ahmad-ih/USB-Armory/README.md

View this project on [CADLAB.io](https://cadlab.io/project/22758). 

# USB-Armory
