ahmad-ih/USB-Armory/mark-one/armory.kicad_pcb

## KiCad design mark-one/armory.kicad_pcb (2020-04-04)

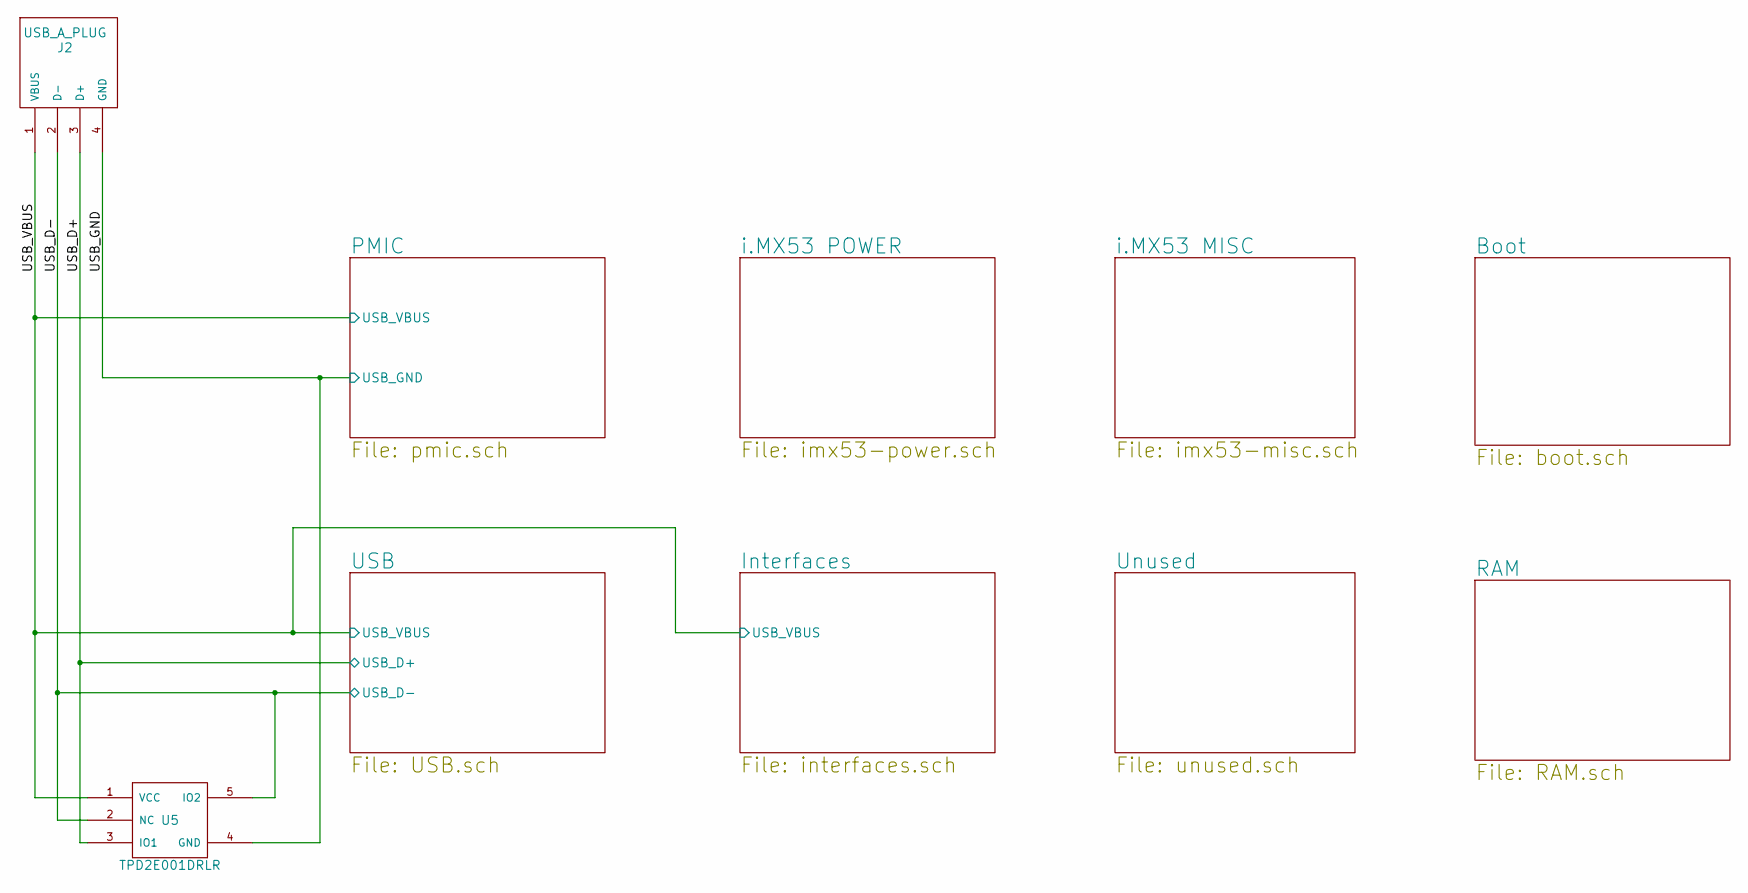
[picture p1: schematic armory.sch, USB ARMORY]

Parts:
J2: USB_A_PLUG; usb-PCB
U5: TPD2E001DRLR; R-PDSO-N5; Mfg PN TPD2E001DRLR

Connections:
/Interfaces/USB_VBUS: J2.1 (VBUS), U5.1 (VCC); also elsewhere on the board
/USB/USB_D+: J2.3 (D+), U5.3 (IO1); also elsewhere on the board
/USB/USB_D-: J2.2 (D-), U5.2 (NC), U5.5 (IO2); also elsewhere on the board
GND: J2.4 (GND), U5.4 (GND); also elsewhere on the board

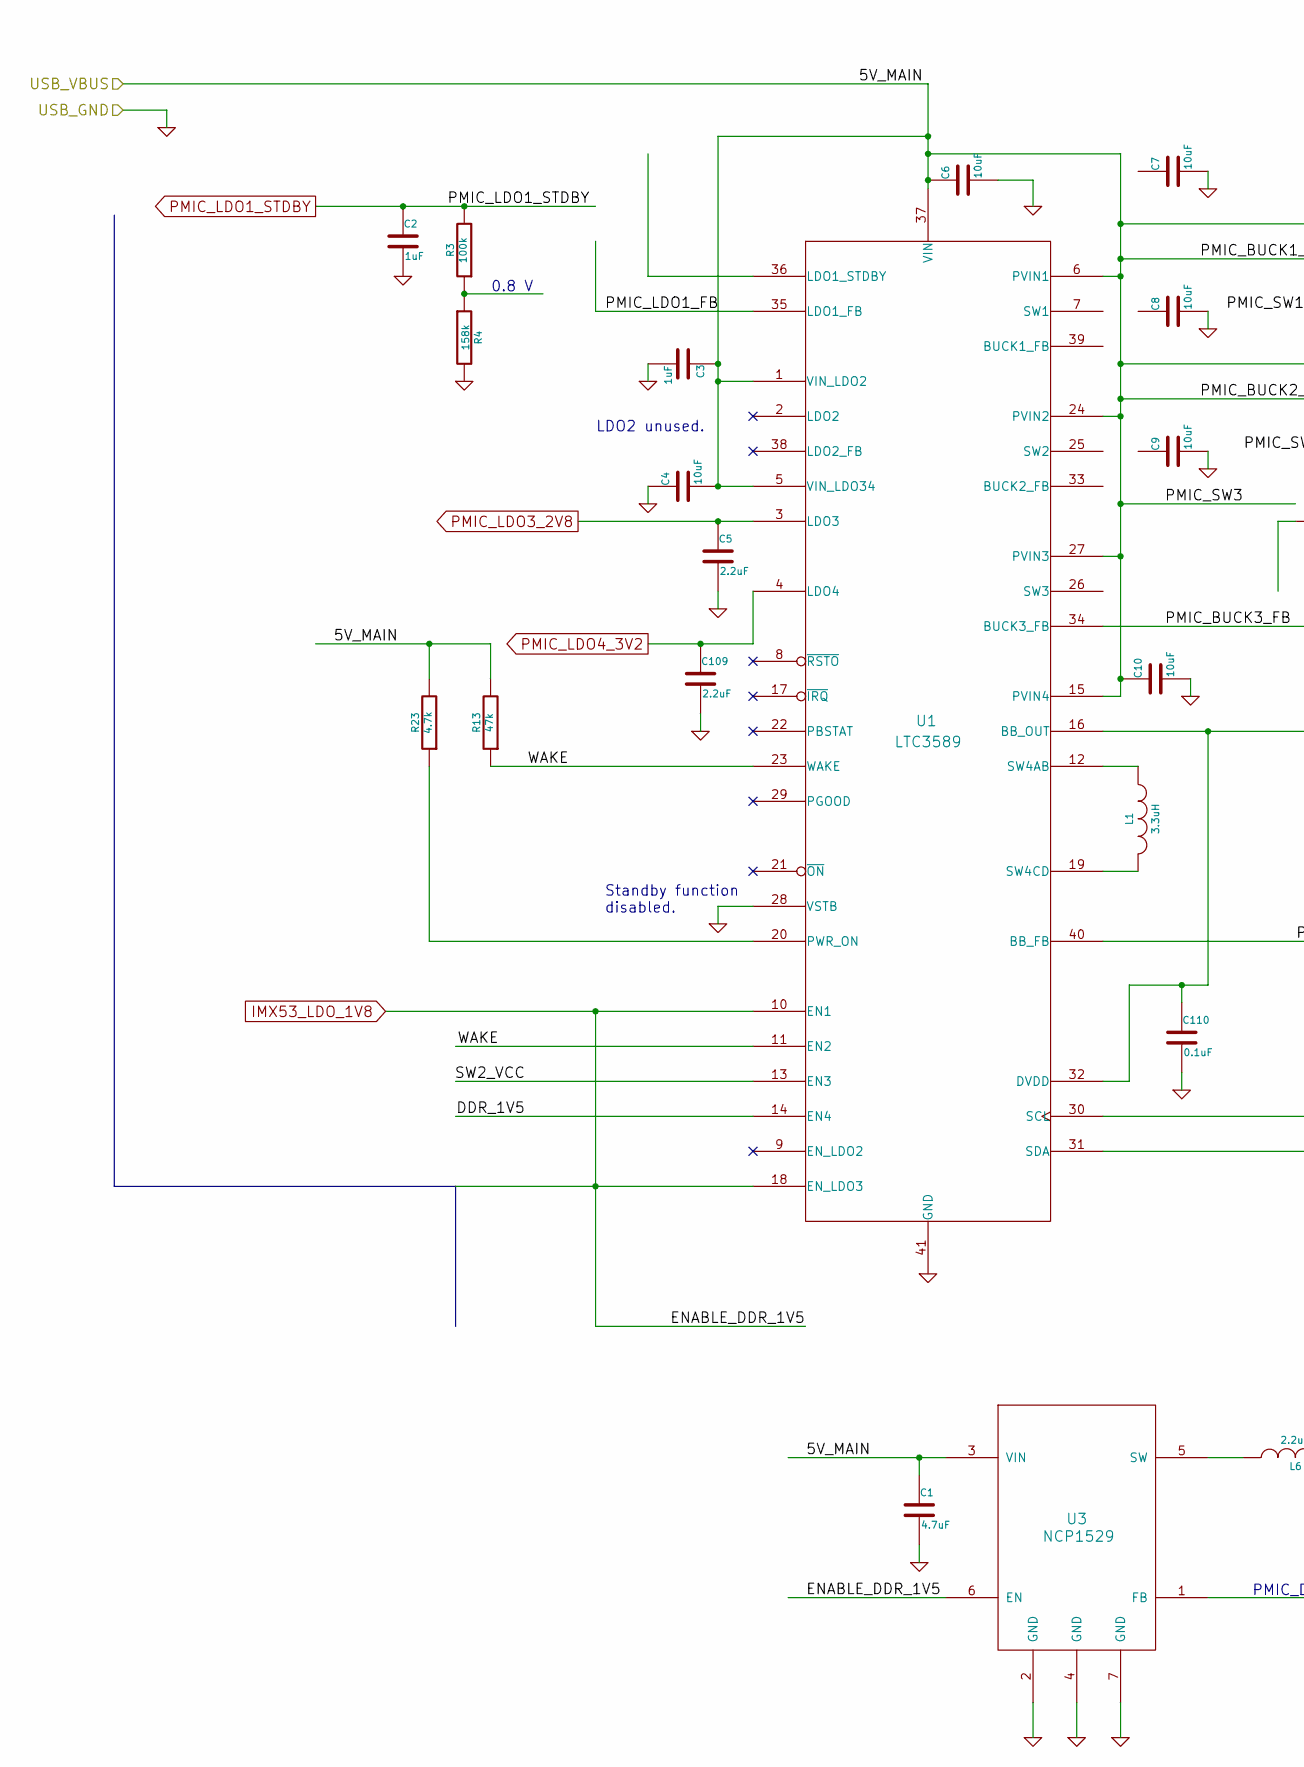
[picture p2: schematic pmic.sch, USB ARMORY - PMIC, part in row 1, column 1]

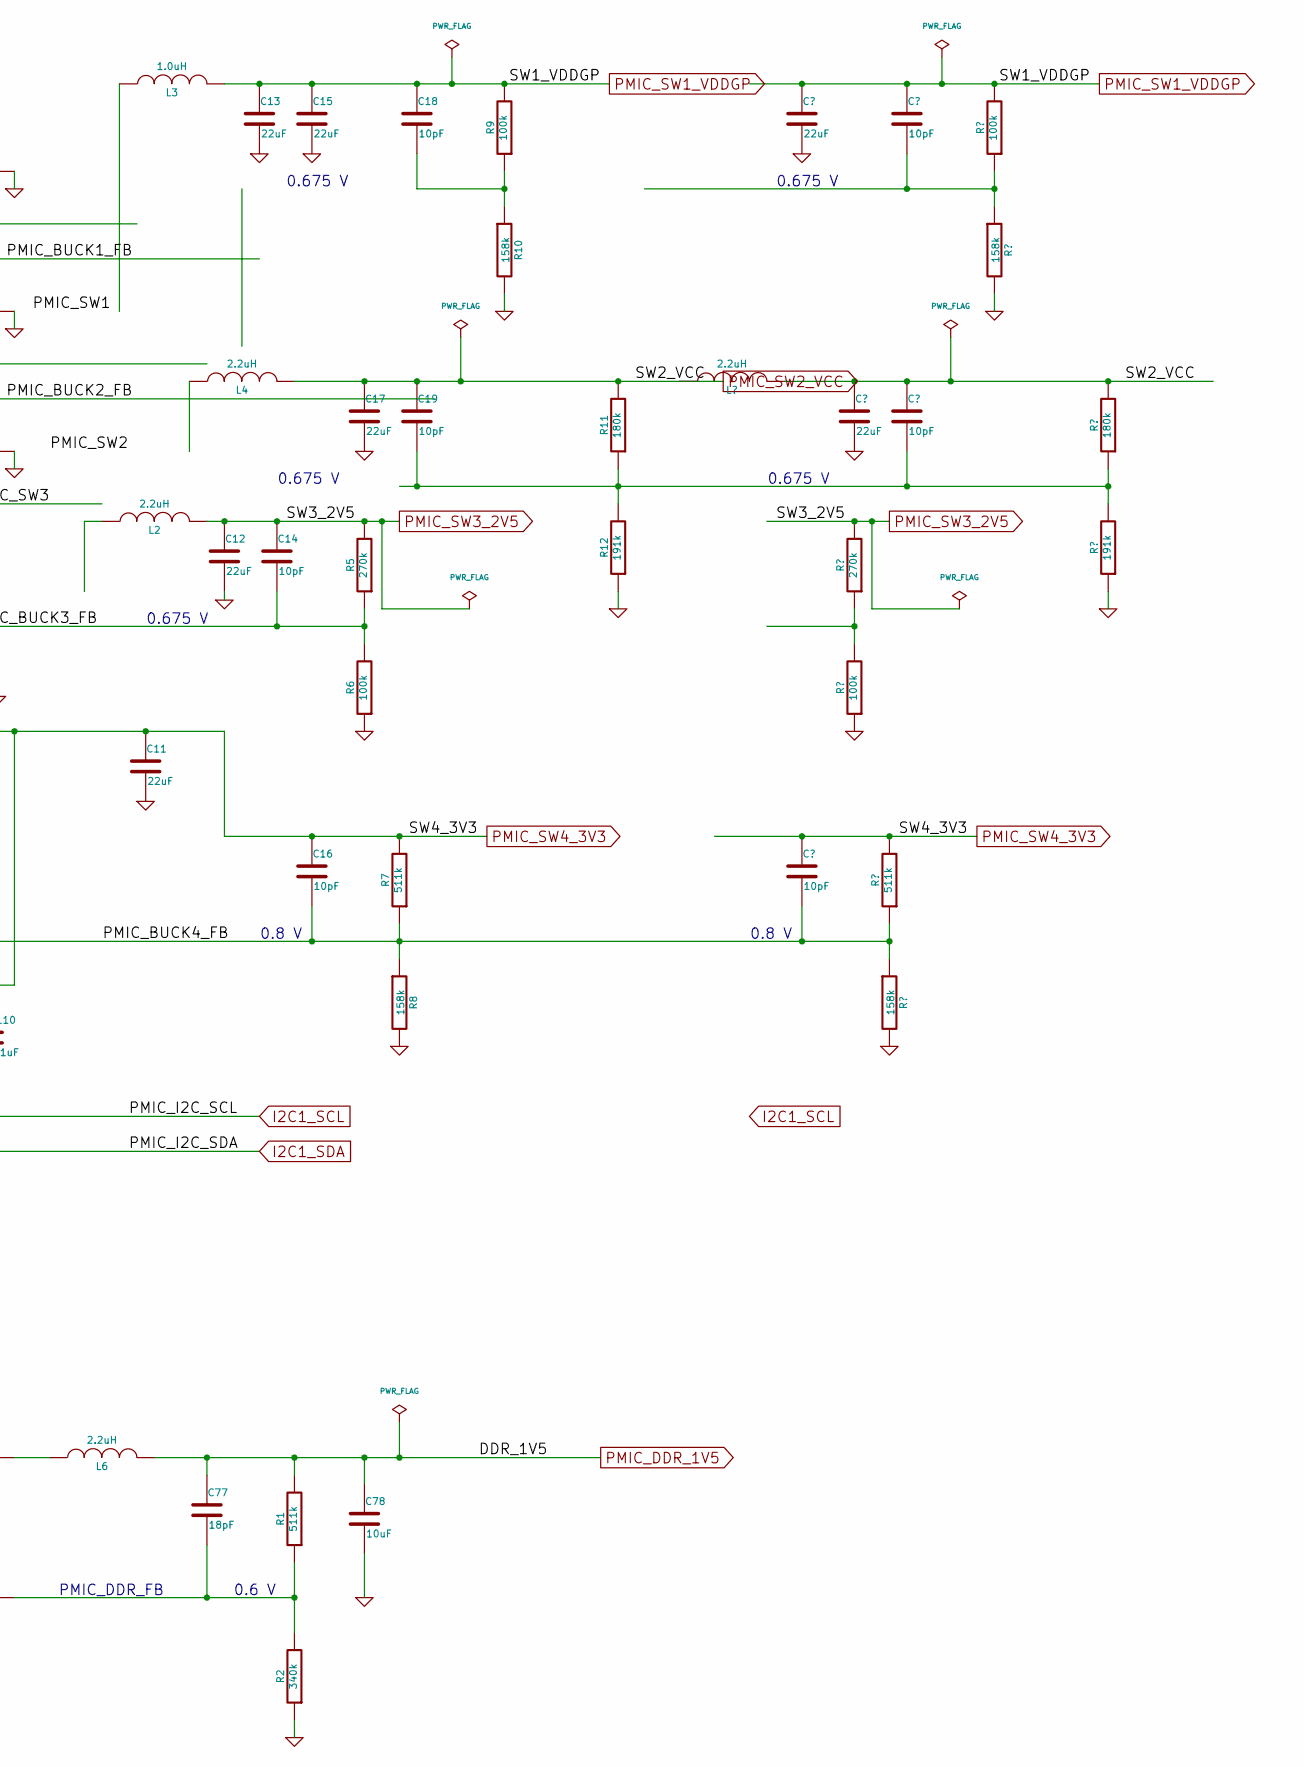
[picture p3: schematic pmic.sch, USB ARMORY - PMIC, part in row 1, column 2]

Parts:
C1: 4.7uF; SM0603; Mfg PN CGB3B1X5R1A475K055AC
C2, C3: 1uF; SM0201; Mfg PN C0603X5R0J105M030BC
C4, C6, C7, C8, C9, C10, C78: 10uF; SM0603; Mfg PN C1608X5R1A106K080AC
C5, C109: 2.2uF; SM0402; Mfg PN C1005X5R0J225K050BC
C11, C12, C13, C15, C17: 22uF; SM0603; Mfg PN C1608X5R0J226M080AC
C14, C16, C18, C19: 10pF; SM0402; Mfg PN 04025U100JAT2A
C77: 18pF; SM0201; Mfg PN C0603C0G1H180J030BA
C110: 0.1uF; SM0201; Mfg PN C0603X5R0J104K030BC
L1: 3.3uH; VLS252012ET; Mfg PN VLS252012ET-3R3M
L2, L4, L6: 2.2uH; VLS252012ET; Mfg PN VLS252012ET-2R2M
L3: 1.0uH; VLS252012ET; Mfg PN VLS252012ET-1R0N
R1, R7: 511k; SM0201; Mfg PN CRCW0201511KFNED
R2: 340k; SM0201; Mfg PN CRCW0201340KFNED
R3, R6, R9: 100k; SM0201; Mfg PN CRCW0201100KFNED
R4, R8, R10: 158k; SM0201; Mfg PN CRCW0201158KFNED
R5: 270k; SM0201; Mfg PN CRCW0201270KFNED
R11: 180k; SM0201; Mfg PN CRCW0201180KFNED
R12: 191k; SM0201; Mfg PN CRCW0201191KFNED
R13: 47k; SM0201; Mfg PN CRCW020147K0FNED
R23: 4.7k; SM0201; Mfg PN CRCW02014K70FNED
U1: LTC3589; ltc3589-QFN40; Mfg PN LTC3589EUJ-2#PBF
U3: NCP1529; Mfg PN NCP1529MUTBG

Connections:
/Interfaces/USB_VBUS: C1.1, C3.1, C4.2, C6.1, C7.1, C8.1, C9.1, C10.1, R13.2, R23.2, U1.1 (VIN_LDO2), U1.5 (VIN_LDO34), U1.6 (PVIN1), U1.15 (PVIN4), U1.24 (PVIN2), U1.27 (PVIN3), U1.37 (VIN), U3.3 (VIN); also elsewhere on the board
/PMIC/PMIC_BUCK1_FB: C18.2, R9.1, R10.1
/PMIC/PMIC_BUCK2_FB: C19.2, R11.1, R12.2
/PMIC/PMIC_BUCK3_FB: C14.2, R5.1, R6.2, U1.34 (BUCK3_FB)
/PMIC/PMIC_BUCK4_FB: C16.2, R7.1, R8.1, U1.40 (BB_FB)
/PMIC/PMIC_LDO1_FB: R3.1, R4.1
/PMIC/PMIC_SW1: L3.1
/PMIC/PMIC_SW3: L2.1
GND: C1.2, C2.2, C3.2, C4.1, C5.2, C6.2, C7.2, C8.2, C9.2, C10.2, C11.2, C12.2, C13.2, C15.2, C17.2, C78.2, C109.2, C110.2, R2.1, R4.2, R6.1, R8.2, R10.2, R12.1, U1.28 (VSTB), U1.41 (GND), U3.2 (GND), U3.4 (GND), U3.7 (GND); also elsewhere on the board
IMX53_LDO_1V8: U1.10 (EN1), U1.18 (EN_LDO3), U3.6 (EN); also elsewhere on the board
unnamed: C77.2, R1.1, R2.2, U3.1 (FB)
unnamed: L1.1, U1.12 (SW4AB)
unnamed: L1.2, U1.19 (SW4CD)
unnamed: L6.1, U3.5 (SW)
unnamed: R13.1, U1.11 (EN2), U1.23 (WAKE)
unnamed: R23.1, U1.20 (PWR_ON)
PMIC_DDR_1V5: C77.1, C78.1, L6.2, R1.2, U1.14 (EN4); also elsewhere on the board
PMIC_LDO1_STDBY: C2.1, R3.2; also elsewhere on the board
PMIC_LDO3_2V8: C5.1, U1.3 (LDO3); also elsewhere on the board
PMIC_LDO4_3V2: C109.1, U1.4 (LDO4); also elsewhere on the board
PMIC_SW1_VDDGP: C13.1, C15.1, C18.1, L3.2, R9.2; also elsewhere on the board
PMIC_SW2_VCC: C17.1, C19.1, L4.2, R11.2, U1.13 (EN3); also elsewhere on the board
PMIC_SW3_2V5: C12.1, C14.1, L2.2, R5.2; also elsewhere on the board
PMIC_SW4_3V3: C11.1, C16.1, C110.1, R7.2, U1.16 (BB_OUT), U1.32 (DVDD); also elsewhere on the board

Notes on the sheet:
Standby function disabled.
0.8 V
0.675 V
LDO2 unused.
0.6 V
PMIC_DDR_FB

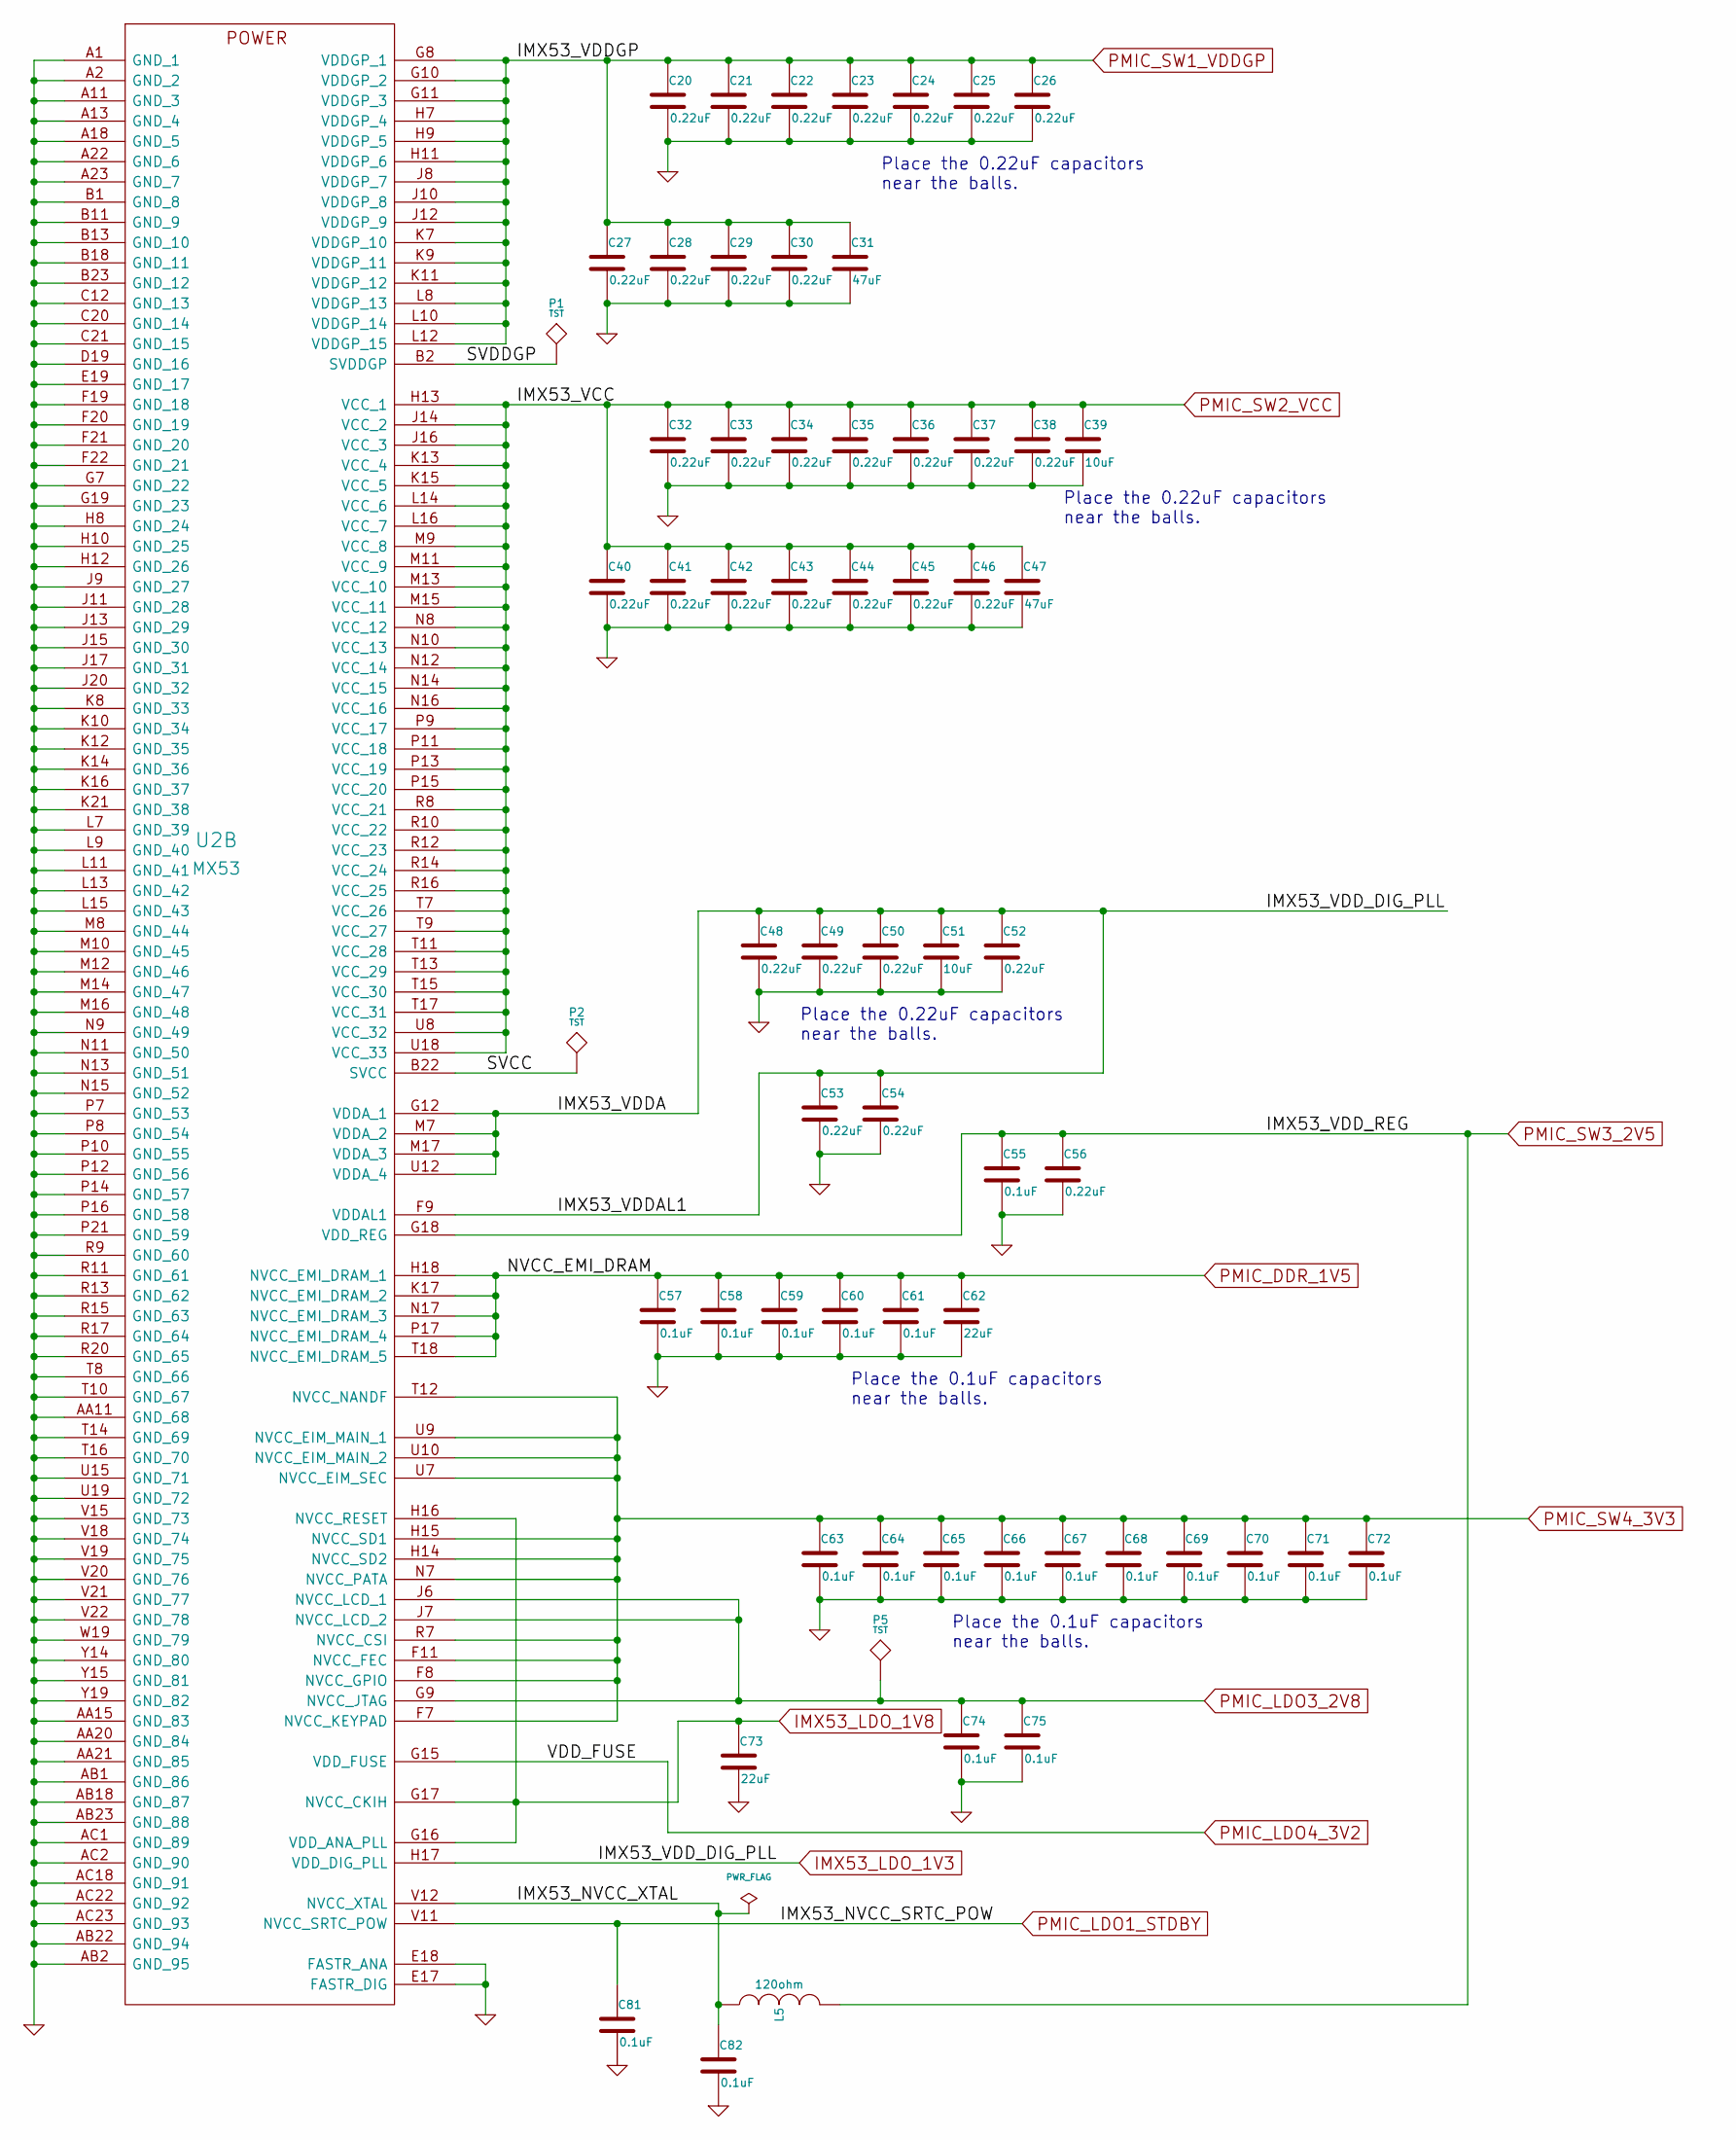
[picture p4: schematic imx53-power.sch, USB ARMORY - i.MX53 POWER]

Parts:
C20, C21, C22, C23, C24, C25, C26, C27, C28, C29, C30, C32, C33, C34, C35, C36, C37, C38, C40, C41, C42, C43, C44, C45, C46, C48, C49, C50, C52, C53, C54, C56: 0.22uF; SM0201; Mfg PN C0603X5R0J224M030BB
C31, C47: 47uF; SM0805; Mfg PN C2012X5R0J476M125AC
C39, C51: 10uF; SM0402; Mfg PN C1005X5R0J106M050BC
C55, C57, C58, C59, C60, C61, C63, C64, C65, C66, C67, C68, C69, C70, C71, C72, C74, C75, C81, C82: 0.1uF; SM0201; Mfg PN C0603X5R0J104K030BC
C62, C73: 22uF; SM0603; Mfg PN C1608X5R0J226M080AC
L5: 120ohm; SM0201; Mfg PN 742692003
P1, P2, P5: TST; TP
U2: MX53; Mfg PN MCIMX537CVV8C / MCIMX536AVV8C / MCIMX53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

Connections:
/i.MX53 POWER/IMX53_NVCC_XTAL: C82.1, L5.1, U2.V12 (NVCC_XTAL)
/i.MX53 POWER/SVCC: P2.1, U2.B22 (SVCC)
/i.MX53 POWER/SVDDGP: P1.1, U2.B2 (SVDDGP)
GND: C20.2, C21.2, C22.2, C23.2, C24.2, C25.2, C26.2, C27.2, C28.2, C29.2, C30.2, C31.2, C32.2, C33.2, C34.2, C35.2, C36.2, C37.2, C38.2, C39.2, C40.2, C41.2, C42.2, C43.2, C44.2, C45.2, C46.2, C47.2, C48.2, C49.2, C50.2, C51.2, C52.2, C53.2, C54.2, C55.2, C56.2, C57.2, C58.2, C59.2, C60.2, C61.2, C62.2, C63.2, C64.2, C65.2, C66.2, C67.2, C68.2, C69.2, C70.2, C71.2, C72.2, C73.2, C74.2, C75.2, C81.2, C82.2, U2.A1 (GND_1), U2.A2 (GND_2), U2.A11 (GND_3), U2.A13 (GND_4), U2.A18 (GND_5), U2.A22 (GND_6), U2.A23 (GND_7), U2.AA11 (GND_68), U2.AA15 (GND_83), U2.AA20 (GND_84), U2.AA21 (GND_85), U2.AB1 (GND_86), U2.AB2 (GND_95), U2.AB18 (GND_87), U2.AB22 (GND_94), U2.AB23 (GND_88), U2.AC1 (GND_89), U2.AC2 (GND_90), U2.AC18 (GND_91), U2.AC22 (GND_92), U2.AC23 (GND_93), U2.B1 (GND_8), U2.B11 (GND_9), U2.B13 (GND_10), U2.B18 (GND_11), U2.B23 (GND_12), U2.C12 (GND_13), U2.C20 (GND_14), U2.C21 (GND_15), U2.D19 (GND_16), U2.E17 (FASTR_DIG), U2.E18 (FASTR_ANA), U2.E19 (GND_17), U2.F19 (GND_18), U2.F20 (GND_19), U2.F21 (GND_20), U2.F22 (GND_21), U2.G7 (GND_22), U2.G19 (GND_23), U2.H8 (GND_24), U2.H10 (GND_25), U2.H12 (GND_26), U2.J9 (GND_27), U2.J11 (GND_28), U2.J13 (GND_29), U2.J15 (GND_30), U2.J17 (GND_31), U2.J20 (GND_32), U2.K8 (GND_33), U2.K10 (GND_34), U2.K12 (GND_35), U2.K14 (GND_36), U2.K16 (GND_37), U2.K21 (GND_38), U2.L7 (GND_39), U2.L9 (GND_40), U2.L11 (GND_41), U2.L13 (GND_42), U2.L15 (GND_43), U2.M8 (GND_44), U2.M10 (GND_45), U2.M12 (GND_46), U2.M14 (GND_47), U2.M16 (GND_48), U2.N9 (GND_49), U2.N11 (GND_50), U2.N13 (GND_51), U2.N15 (GND_52), U2.P7 (GND_53), U2.P8 (GND_54), U2.P10 (GND_55), U2.P12 (GND_56), U2.P14 (GND_57), U2.P16 (GND_58), U2.P21 (GND_59), U2.R9 (GND_60), U2.R11 (GND_61), U2.R13 (GND_62), U2.R15 (GND_63), U2.R17 (GND_64), U2.R20 (GND_65), U2.T8 (GND_66), U2.T10 (GND_67), U2.T14 (GND_69), U2.T16 (GND_70), U2.U15 (GND_71), U2.U19 (GND_72), U2.V15 (GND_73), U2.V18 (GND_74), U2.V19 (GND_75), U2.V20 (GND_76), U2.V21 (GND_77), U2.V22 (GND_78), U2.W19 (GND_79), U2.Y14 (GND_80), U2.Y15 (GND_81), U2.Y19 (GND_82); also elsewhere on the board
IMX53_LDO_1V3: C48.1, C49.1, C50.1, C51.1, C52.1, C53.1, C54.1, U2.F9 (VDDAL1), U2.G12 (VDDA_1), U2.H17 (VDD_DIG_PLL), U2.M7 (VDDA_2), U2.M17 (VDDA_3), U2.U12 (VDDA_4)
IMX53_LDO_1V8: C73.1, U2.G16 (VDD_ANA_PLL), U2.G17 (NVCC_CKIH), U2.H16 (NVCC_RESET); also elsewhere on the board
PMIC_DDR_1V5: C57.1, C58.1, C59.1, C60.1, C61.1, C62.1, U2.H18 (NVCC_EMI_DRAM_1), U2.K17 (NVCC_EMI_DRAM_2), U2.N17 (NVCC_EMI_DRAM_3), U2.P17 (NVCC_EMI_DRAM_4), U2.T18 (NVCC_EMI_DRAM_5); also elsewhere on the board
PMIC_LDO1_STDBY: C81.1, U2.V11 (NVCC_SRTC_POW); also elsewhere on the board
PMIC_LDO3_2V8: C74.1, C75.1, P5.1, U2.G9 (NVCC_JTAG), U2.J6 (NVCC_LCD_1), U2.J7 (NVCC_LCD_2); also elsewhere on the board
PMIC_LDO4_3V2: U2.G15 (VDD_FUSE); also elsewhere on the board
PMIC_SW1_VDDGP: C20.1, C21.1, C22.1, C23.1, C24.1, C25.1, C26.1, C27.1, C28.1, C29.1, C30.1, C31.1, U2.G8 (VDDGP_1), U2.G10 (VDDGP_2), U2.G11 (VDDGP_3), U2.H7 (VDDGP_4), U2.H9 (VDDGP_5), U2.H11 (VDDGP_6), U2.J8 (VDDGP_7), U2.J10 (VDDGP_8), U2.J12 (VDDGP_9), U2.K7 (VDDGP_10), U2.K9 (VDDGP_11), U2.K11 (VDDGP_12), U2.L8 (VDDGP_13), U2.L10 (VDDGP_14), U2.L12 (VDDGP_15); also elsewhere on the board
PMIC_SW2_VCC: C32.1, C33.1, C34.1, C35.1, C36.1, C37.1, C38.1, C39.1, C40.1, C41.1, C42.1, C43.1, C44.1, C45.1, C46.1, C47.1, U2.H13 (VCC_1), U2.J14 (VCC_2), U2.J16 (VCC_3), U2.K13 (VCC_4), U2.K15 (VCC_5), U2.L14 (VCC_6), U2.L16 (VCC_7), U2.M9 (VCC_8), U2.M11 (VCC_9), U2.M13 (VCC_10), U2.M15 (VCC_11), U2.N8 (VCC_12), U2.N10 (VCC_13), U2.N12 (VCC_14), U2.N14 (VCC_15), U2.N16 (VCC_16), U2.P9 (VCC_17), U2.P11 (VCC_18), U2.P13 (VCC_19), U2.P15 (VCC_20), U2.R8 (VCC_21), U2.R10 (VCC_22), U2.R12 (VCC_23), U2.R14 (VCC_24), U2.R16 (VCC_25), U2.T7 (VCC_26), U2.T9 (VCC_27), U2.T11 (VCC_28), U2.T13 (VCC_29), U2.T15 (VCC_30), U2.T17 (VCC_31), U2.U8 (VCC_32), U2.U18 (VCC_33); also elsewhere on the board
PMIC_SW3_2V5: C55.1, C56.1, L5.2, U2.G18 (VDD_REG); also elsewhere on the board
PMIC_SW4_3V3: C63.1, C64.1, C65.1, C66.1, C67.1, C68.1, C69.1, C70.1, C71.1, C72.1, U2.F7 (NVCC_KEYPAD), U2.F8 (NVCC_GPIO), U2.F11 (NVCC_FEC), U2.H14 (NVCC_SD2), U2.H15 (NVCC_SD1), U2.N7 (NVCC_PATA), U2.R7 (NVCC_CSI), U2.T12 (NVCC_NANDF), U2.U7 (NVCC_EIM_SEC), U2.U9 (NVCC_EIM_MAIN_1), U2.U10 (NVCC_EIM_MAIN_2); also elsewhere on the board

Notes on the sheet:
Place the 0.22uF capacitors near the balls.
Place the 0.1uF capacitors near the balls.

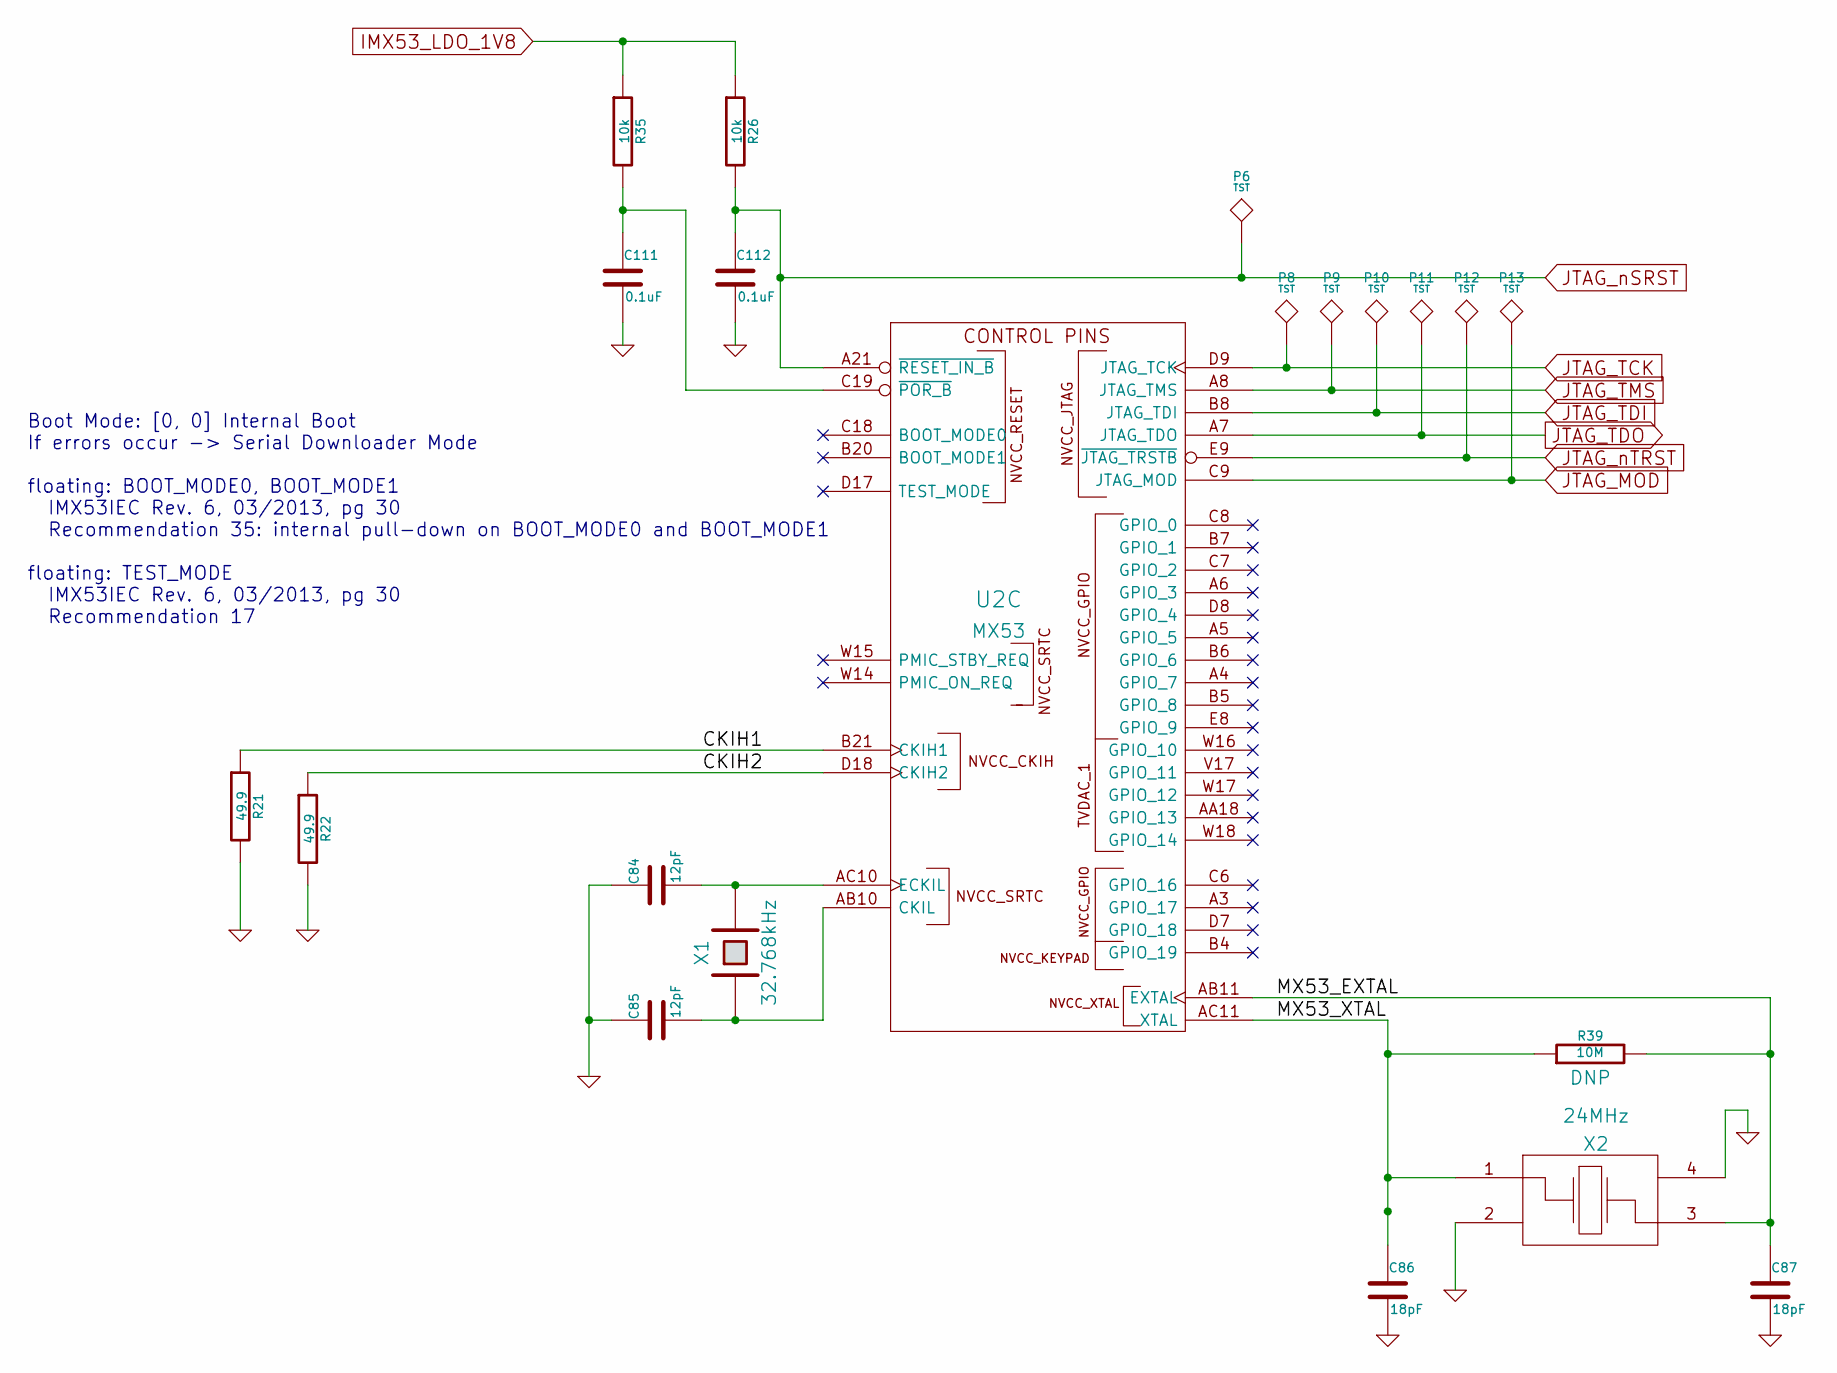
[picture p5: schematic imx53-misc.sch, USB ARMORY - i.MX53 GPIOs]

Parts:
C84, C85: 12pF; SM0201; Mfg PN C0603C0G1E120J030BA
C86, C87: 18pF; SM0201; Mfg PN C0603C0G1H180J030BA
C111, C112: 0.1uF; SM0201; Mfg PN C0603X5R0J104K030BC
P6, P8, P9, P10, P11, P12, P13: TST; TP
R21, R22: 49.9; SM0201; Mfg PN CRCW020149R9FNED
R26, R35: 10k; SM0201; Mfg PN CRCW020110K0FNED
R39: 10M; SM0201; Mfg PN CRCW020110M0FNED
U2: MX53
X1: 32.768kHz; CRYSTAL-32k-B; Mfg PN ABS07-32.768KHZ-9-T
X2: 24MHz; CRYSTAL-24M-B; Mfg PN 7M-24.000MEEQ-T

Connections:
/i.MX53 MISC/CKIH1: R21.1, U2.B21 (CKIH1)
/i.MX53 MISC/CKIH2: R22.1, U2.D18 (CKIH2)
/i.MX53 MISC/MX53_EXTAL: C87.1, R39.2, U2.AB11 (EXTAL), X2.3
/i.MX53 MISC/MX53_XTAL: C86.1, R39.1, U2.AC11 (XTAL), X2.1
GND: C84.1, C85.1, C86.2, C87.2, C111.2, C112.2, R21.2, R22.2, X2.2, X2.4; also elsewhere on the board
IMX53_LDO_1V8: R26.1, R35.1; also elsewhere on the board
JTAG_MOD: P13.1, U2.C9 (JTAG_MOD)
JTAG_TCK: P8.1, U2.D9 (JTAG_TCK)
JTAG_TDI: P10.1, U2.B8 (JTAG_TDI)
JTAG_TDO: P11.1, U2.A7 (JTAG_TDO)
JTAG_TMS: P9.1, U2.A8 (JTAG_TMS)
JTAG_nSRST: C112.1, P6.1, R26.2, U2.A21 (~RESET_IN_B)
JTAG_nTRST: P12.1, U2.E9 (~JTAG_TRSTB)
unnamed: C84.2, U2.AC10 (ECKIL), X1.2
unnamed: C85.2, U2.AB10 (CKIL), X1.1
unnamed: C111.1, R35.2, U2.C19 (~POR_B)

Notes on the sheet:
Boot Mode: [0, 0] Internal Boot If errors occur -> Serial Downloader Mode floating: BOOT_MODE0, BOOT_MODE1 IMX53IEC Rev. 6, 03/2013, pg 30 Recommendation 35: internal pull-down on BOOT_MODE0 and BOOT_MODE1 floating: TEST_MODE IMX53IEC Rev. 6, 03/2013, pg 30 Recommendation 17

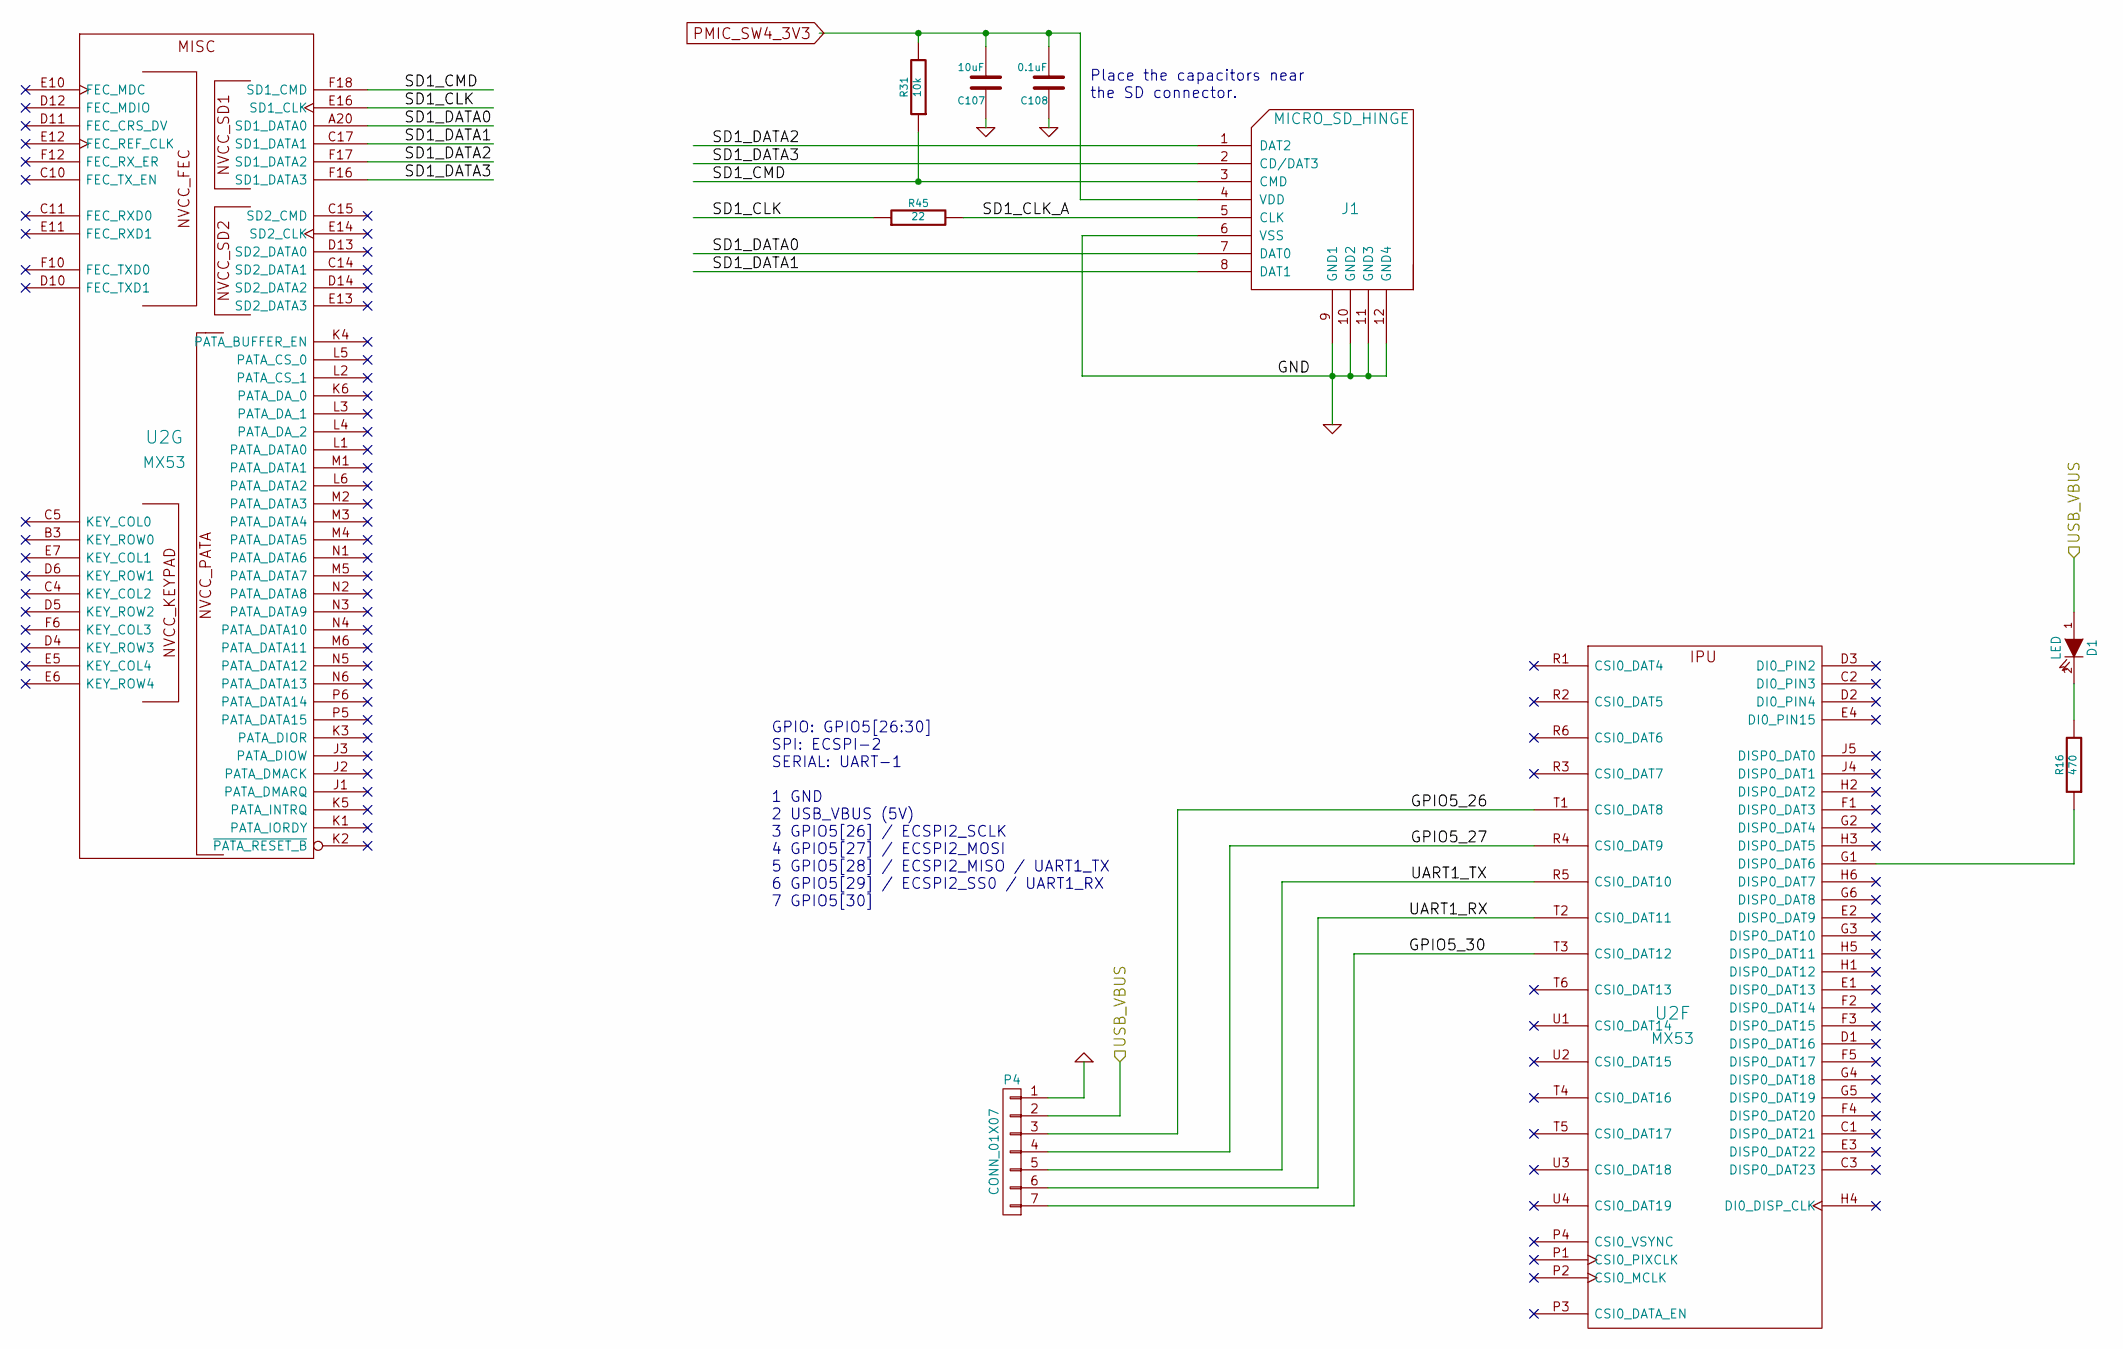
[picture p6: schematic interfaces.sch, USB ARMORY - i.MX53 SD INTERFACE]

Parts:
C107: 10uF; SM0603; Mfg PN C1608X5R1A106K080AC
C108: 0.1uF; SM0201; Mfg PN C0603X5R0J104K030BC
D1: LED; SM0603LED; Mfg PN VLMW1300-GS08
J1: MICRO_SD_HINGE; MICRO_SD_HINGE_AMP; Mfg PN 101-00303-68
P4: CONN_01X07; pinhead-1X7
R16: 470; SM0201; Mfg PN CRCW0201470RFNED
R31: 10k; SM0201; Mfg PN CRCW020110K0FNED
R45: 22; SM0201; Mfg PN CRCW020122R0FNED
U2: MX53

Connections:
/Interfaces/GPIO5_26: P4.3, U2.T1 (CSI0_DAT8); also elsewhere on the board
/Interfaces/GPIO5_27: P4.4, U2.R4 (CSI0_DAT9); also elsewhere on the board
/Interfaces/GPIO5_30: P4.7, U2.T3 (CSI0_DAT12); also elsewhere on the board
/Interfaces/SD1_CLK: R45.1, U2.E16 (SD1_CLK)
/Interfaces/SD1_CLK_A: J1.5 (CLK), R45.2
/Interfaces/SD1_CMD: J1.3 (CMD), R31.1, U2.F18 (SD1_CMD)
/Interfaces/SD1_DATA0: J1.7 (DAT0), U2.A20 (SD1_DATA0)
/Interfaces/SD1_DATA1: J1.8 (DAT1), U2.C17 (SD1_DATA1)
/Interfaces/SD1_DATA2: J1.1 (DAT2), U2.F17 (SD1_DATA2)
/Interfaces/SD1_DATA3: J1.2 (CD/DAT3), U2.F16 (SD1_DATA3)
/Interfaces/UART1_RX: P4.6, U2.T2 (CSI0_DAT11); also elsewhere on the board
/Interfaces/UART1_TX: P4.5, U2.R5 (CSI0_DAT10); also elsewhere on the board
/Interfaces/USB_VBUS: D1.1 (A), P4.2; also elsewhere on the board
GND: C107.1, C108.1, J1.6 (VSS), J1.9 (GND1), J1.10 (GND2), J1.11 (GND3), J1.12 (GND4), P4.1; also elsewhere on the board
unnamed: D1.2 (K), R16.2
unnamed: R16.1, U2.G1 (DISP0_DAT6)
PMIC_SW4_3V3: C107.2, C108.2, J1.4 (VDD), R31.2; also elsewhere on the board

Notes on the sheet:
Place the capacitors near the SD connector.
GPIO: GPIO5[26:30] SPI: ECSPI-2 SERIAL: UART-1 1 GND 2 USB_VBUS (5V) 3 GPIO5[26] / ECSPI2_SCLK 4 GPIO5[27] / ECSPI2_MOSI 5 GPIO5[28] / ECSPI2_MISO / UART1_TX 6 GPIO5[29] / ECSPI2_SS0 / UART1_RX 7 GPIO5[30]
