ahmad-ih/USB-Armory/mark-one/armory.kicad_pcb

## KiCad design mark-one/armory.kicad_pcb (continued)

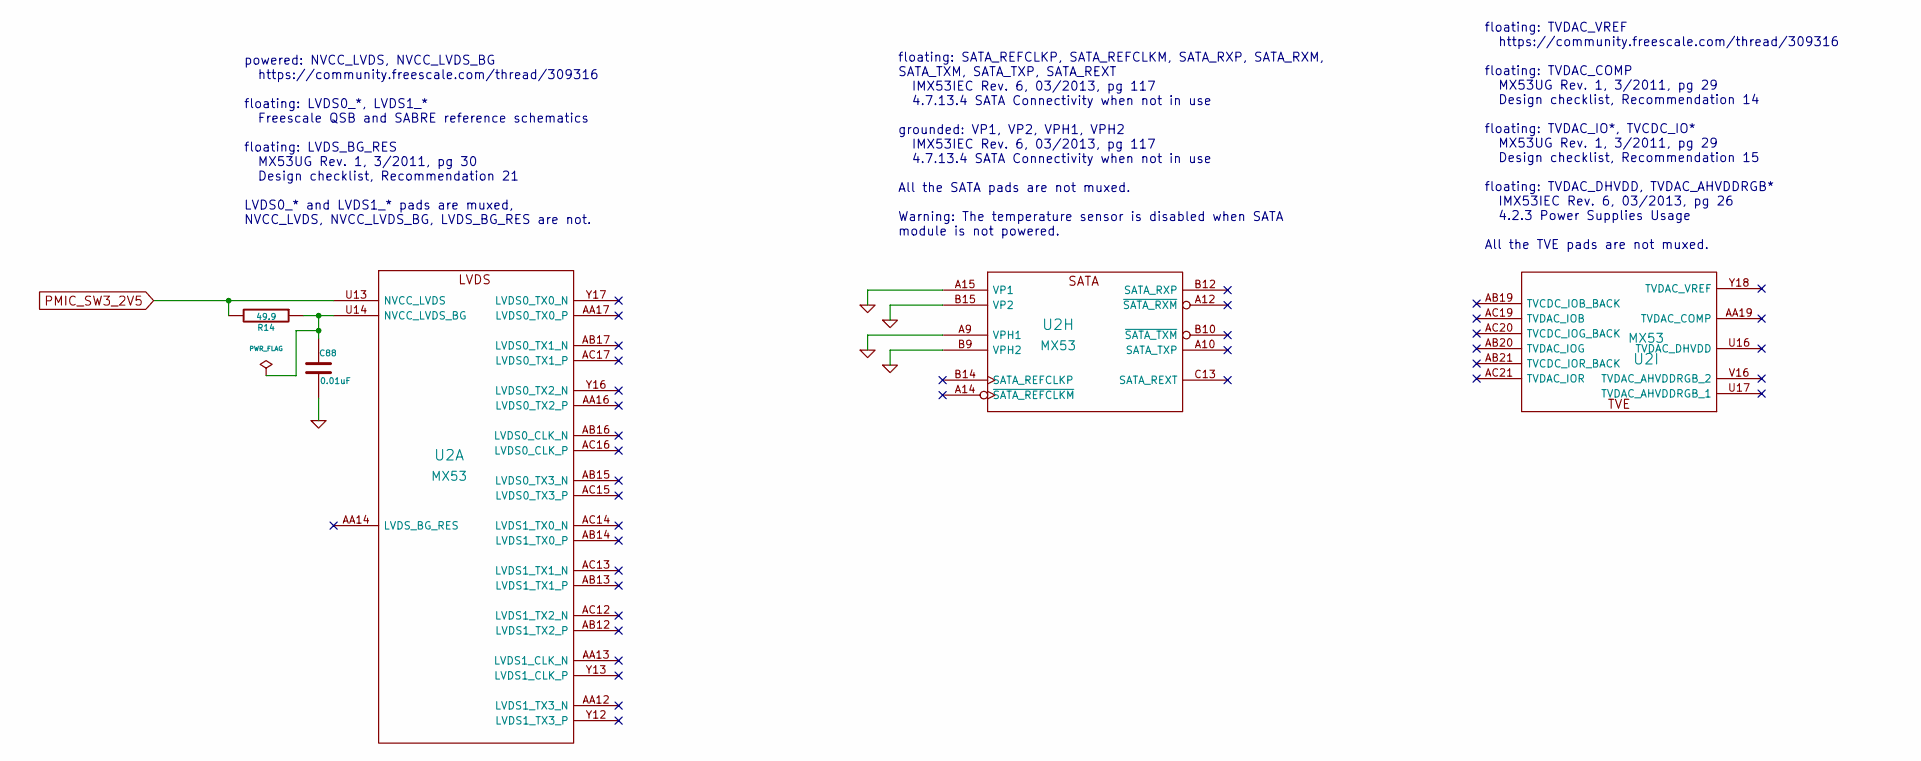
[picture p7: schematic unused.sch, USB ARMORY - i.MX53 UNUSED]

Parts:
C88: 0.01uF; SM0201; Mfg PN C0603X7R1A103K030BA
R14: 49.9; SM0201; Mfg PN CRCW020149R9FNED
U2: MX53

Connections:
GND: C88.2, U2.A9 (VPH1), U2.A15 (VP1), U2.B9 (VPH2), U2.B15 (VP2); also elsewhere on the board
unnamed: C88.1, R14.1, U2.U14 (NVCC_LVDS_BG)
PMIC_SW3_2V5: R14.2, U2.U13 (NVCC_LVDS); also elsewhere on the board

Notes on the sheet:
floating: TVDAC_VREF https://community.freescale.com/thread/309316 floating: TVDAC_COMP MX53UG Rev. 1, 3/2011, pg 29 Design checklist, Recommendation 14 floating: TVDAC_IO*, TVCDC_IO* MX53UG Rev. 1, 3/2011, pg 29 Design checklist, Recommendation 15 floating: TVDAC_DHVDD, TVDAC_AHVDDRGB* IMX53IEC Re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
powered: NVCC_LVDS, NVCC_LVDS_BG https://community.freescale.com/thread/309316 floating: LVDS0_*, LVDS1_* Freescale QSB and SABRE reference schematics floating: LVDS_BG_RES MX53UG Rev. 1, 3/2011, pg 30 Design checklist, Recommendation 21 LVDS0_* and LVDS1_* pads are muxed, NVCC_LVDS, NVCC_LVDS_BG, 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
floating: SATA_REFCLKP, SATA_REFCLKM, SATA_RXP, SATA_RXM, SATA_TXM, SATA_TXP, SATA_REXT IMX53IEC Rev. 6, 03/2013, pg 117 4.7.13.4 SATA Connectivity when not in use grounded: VP1, VP2, VPH1, VPH2 IMX53IEC Rev. 6, 03/2013, pg 117 4.7.13.4 SATA Connectivity when not in use All the SATA pads are not mu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

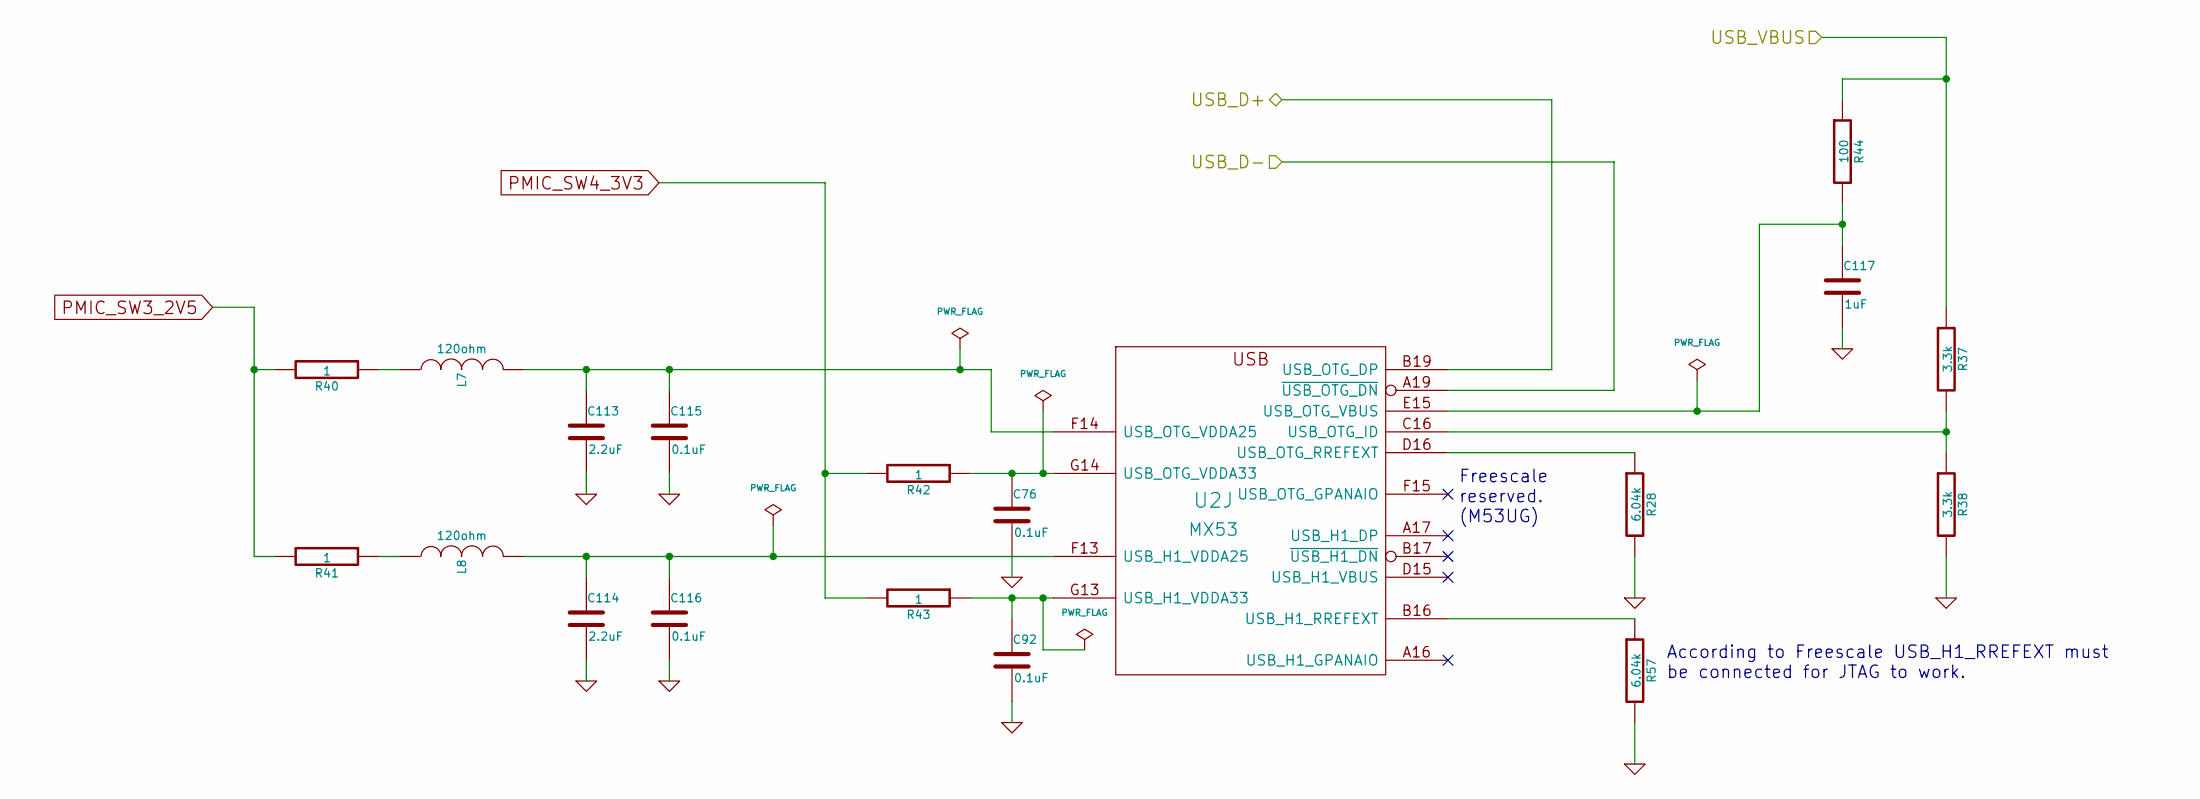
[picture p8: schematic USB.sch, USB ARMORY - i.MX53 USB]

Parts:
C76, C92, C115, C116: 0.1uF; SM0201; Mfg PN C0603X5R0J104K030BC
C113, C114: 2.2uF; SM0402; Mfg PN C1005X5R0J225K050BC
C117: 1uF; SM0201; Mfg PN C0603X5R0J105M030BC
L7, L8: 120ohm; SM0201; Mfg PN 742692003
R28, R57: 6.04k; SM0201; Mfg PN CRCW02016K04FNED
R37, R38: 3.3k; SM0201; Mfg PN CRCW02013K30FNED
R40, R41, R42, R43: 1; SM0201; Mfg PN MCRE000220
R44: 100; SM0201; Mfg PN CRCW0201100RFNED
U2: MX53

Connections:
/Interfaces/USB_VBUS: R37.1, R44.1; also elsewhere on the board
/USB/USB_D+: U2.B19 (USB_OTG_DP); also elsewhere on the board
/USB/USB_D-: U2.A19 (~USB_OTG_DN); also elsewhere on the board
GND: C76.2, C92.2, C113.2, C114.2, C115.2, C116.2, C117.2, R28.2, R38.2, R57.2; also elsewhere on the board
unnamed: C76.1, R42.1, U2.G14 (USB_OTG_VDDA33)
unnamed: C92.1, R43.1, U2.G13 (USB_H1_VDDA33)
unnamed: C113.1, C115.1, L7.2, U2.F14 (USB_OTG_VDDA25)
unnamed: C114.1, C116.1, L8.2, U2.F13 (USB_H1_VDDA25)
unnamed: C117.1, R44.2, U2.E15 (USB_OTG_VBUS)
unnamed: L7.1, R40.1
unnamed: L8.1, R41.1
unnamed: R28.1, U2.D16 (USB_OTG_RREFEXT)
unnamed: R37.2, R38.1, U2.C16 (USB_OTG_ID)
unnamed: R57.1, U2.B16 (USB_H1_RREFEXT)
PMIC_SW3_2V5: R40.2, R41.2; also elsewhere on the board
PMIC_SW4_3V3: R42.2, R43.2; also elsewhere on the board

Notes on the sheet:
Freescale reserved. (M53UG)
According to Freescale USB_H1_RREFEXT must be connected for JTAG to work.

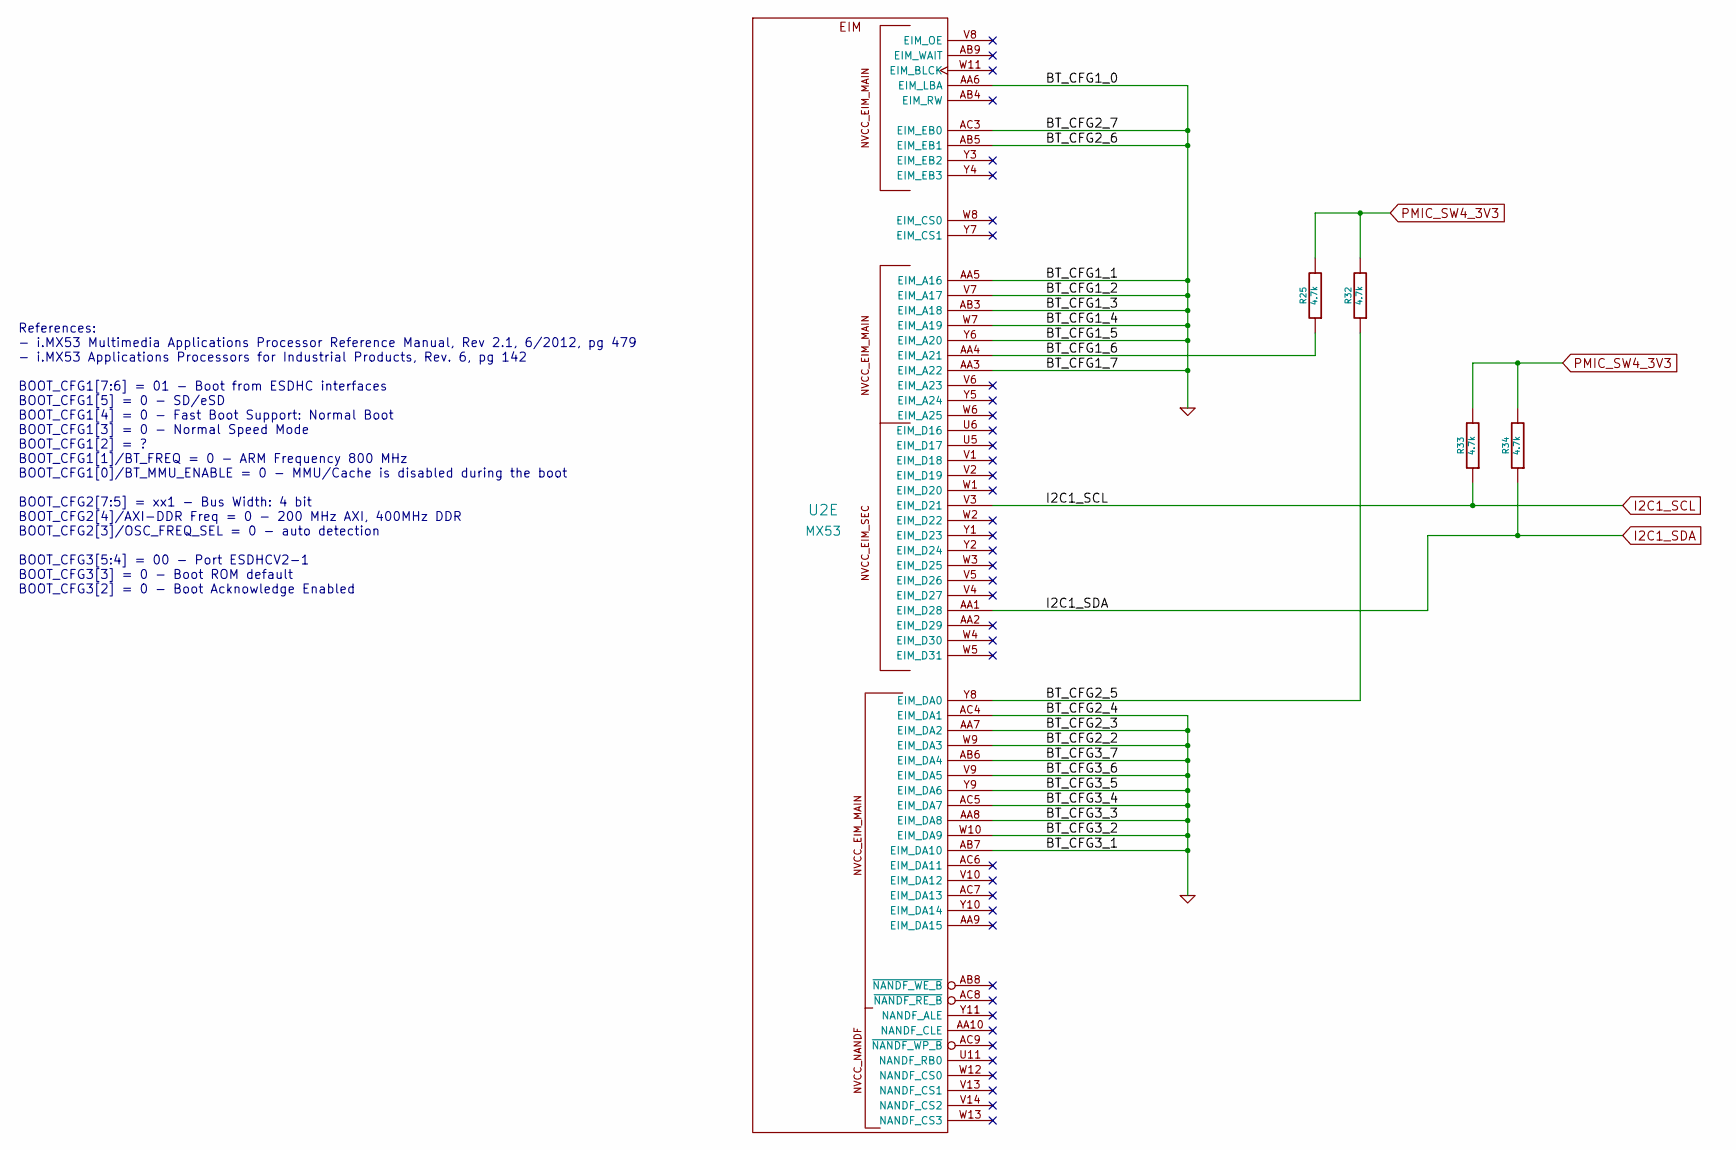
[picture p9: schematic boot.sch, USB ARMORY - BOOT]

Parts:
R25, R32, R33, R34: 4.7k; SM0201; Mfg PN CRCW02014K70FNED
U2: MX53

Connections:
/Boot/BT_CFG1_6: R25.1, U2.AA4 (EIM_A21)
/Boot/BT_CFG2_5: R32.1, U2.Y8 (EIM_DA0)
GND: U2.AA3 (EIM_A22), U2.AA5 (EIM_A16), U2.AA6 (EIM_LBA), U2.AA7 (EIM_DA2), U2.AA8 (EIM_DA8), U2.AB3 (EIM_A18), U2.AB5 (EIM_EB1), U2.AB6 (EIM_DA4), U2.AB7 (EIM_DA10), U2.AC3 (EIM_EB0), U2.AC4 (EIM_DA1), U2.AC5 (EIM_DA7), U2.V7 (EIM_A17), U2.V9 (EIM_DA5), U2.W7 (EIM_A19), U2.W9 (EIM_DA3), U2.W10 (EIM_DA9), U2.Y6 (EIM_A20), U2.Y9 (EIM_DA6); also elsewhere on the board
I2C1_SCL: R33.1, U2.V3 (EIM_D21)
I2C1_SDA: R34.1, U2.AA1 (EIM_D28)
PMIC_SW4_3V3: R25.2, R32.2, R33.2, R34.2; also elsewhere on the board

Notes on the sheet:
References: - i.MX53 Multimedia Applications Processor Reference Manual, Rev 2.1, 6/2012, pg 479 - i.MX53 Applications Processors for Industrial Products, Rev. 6, pg 142 BOOT_CFG1[7:6] = 01 - Boot from ESDHC interfaces BOOT_CFG1[5] = 0 - SD/eSD BOOT_CFG1[4] = 0 - Fast Boot Support: Normal Boot BOOT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

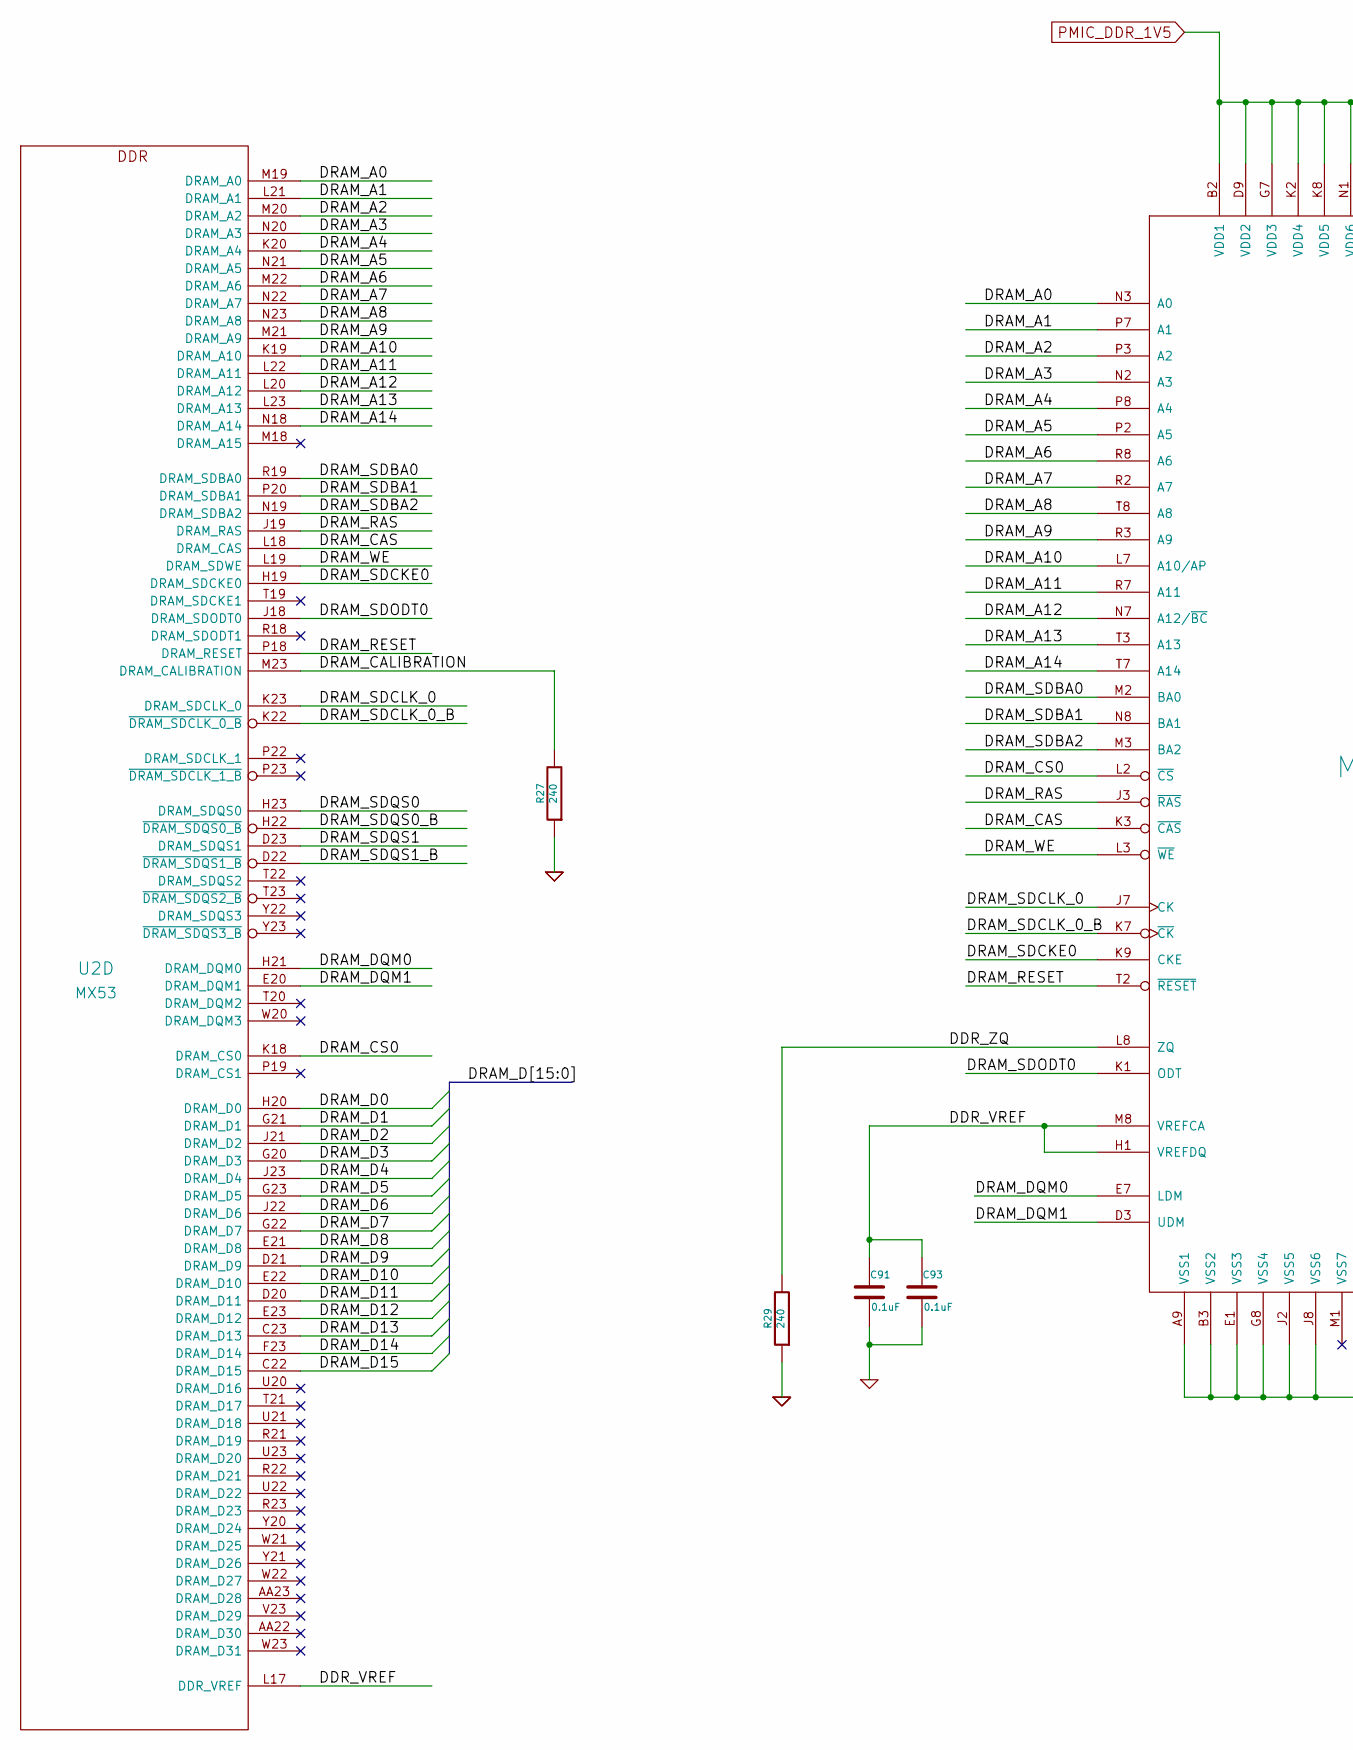
[picture p10: schematic RAM.sch, USB ARMORY - i.MX53 DDR3, part in row 1, column 1]

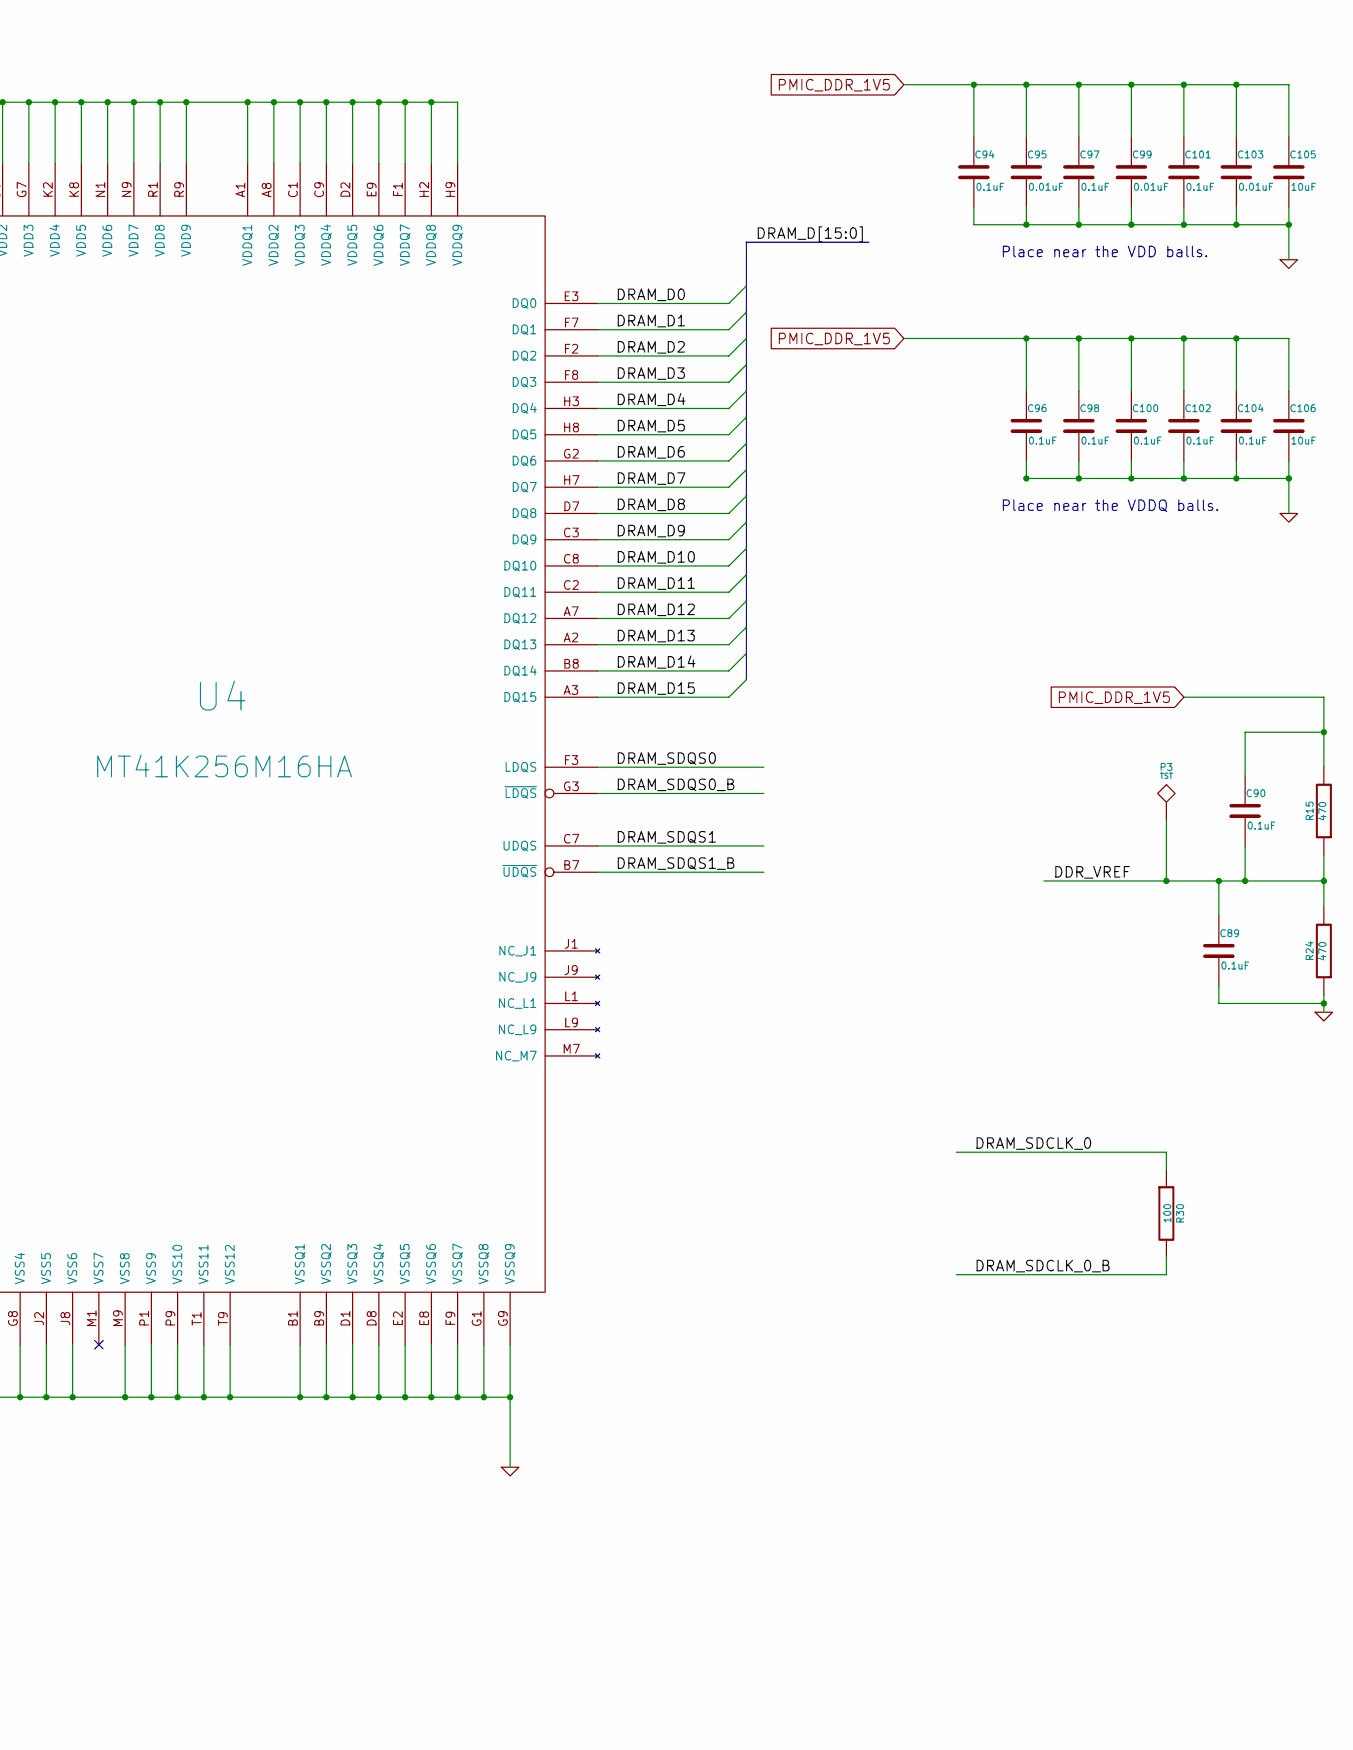
[picture p11: schematic RAM.sch, USB ARMORY - i.MX53 DDR3, part in row 1, column 2]

Parts:
C89, C90, C91, C93, C94, C96, C97, C98, C100, C101, C102, C104: 0.1uF; SM0201; Mfg PN C0603X5R0J104K030BC
C95, C99, C103: 0.01uF; SM0201; Mfg PN C0603X7R1A103K030BA
C105, C106: 10uF; SM0603; Mfg PN C1608X5R1A106K080AC
P3: TST; TP
R15, R24: 470; SM0201; Mfg PN CRCW0201470RFNED
R27, R29: 240; SM0201; Mfg PN CRCW0201240RFNED
R30: 100; SM0603; Mfg PN CRCW0603100RFKEA
U2: MX53
U4: MT41K256M16HA; micron-96-fbga-ha; Mfg PN MT41K256M16HA-107

Connections:
/RAM/DDR_VREF: C89.1, C90.2, C91.1, C93.1, P3.1, R15.1, R24.2, U2.L17 (DDR_VREF), U4.H1 (VREFDQ), U4.M8 (VREFCA)
/RAM/DDR_ZQ: R29.2, U4.L8 (ZQ)
/RAM/DRAM_A0: U2.M19 (DRAM_A0), U4.N3 (A0)
/RAM/DRAM_A1: U2.L21 (DRAM_A1), U4.P7 (A1)
/RAM/DRAM_A2: U2.M20 (DRAM_A2), U4.P3 (A2)
/RAM/DRAM_A3: U2.N20 (DRAM_A3), U4.N2 (A3)
/RAM/DRAM_A4: U2.K20 (DRAM_A4), U4.P8 (A4)
/RAM/DRAM_A5: U2.N21 (DRAM_A5), U4.P2 (A5)
/RAM/DRAM_A6: U2.M22 (DRAM_A6), U4.R8 (A6)
/RAM/DRAM_A7: U2.N22 (DRAM_A7), U4.R2 (A7)
/RAM/DRAM_A8: U2.N23 (DRAM_A8), U4.T8 (A8)
/RAM/DRAM_A9: U2.M21 (DRAM_A9), U4.R3 (A9)
/RAM/DRAM_A10: U2.K19 (DRAM_A10), U4.L7 (A10/AP)
/RAM/DRAM_A11: U2.L22 (DRAM_A11), U4.R7 (A11)
/RAM/DRAM_A12: U2.L20 (DRAM_A12), U4.N7 (A12/~BC)
/RAM/DRAM_A13: U2.L23 (DRAM_A13), U4.T3 (A13)
/RAM/DRAM_A14: U2.N18 (DRAM_A14), U4.T7 (A14)
/RAM/DRAM_CALIBRATION: R27.2, U2.M23 (DRAM_CALIBRATION)
/RAM/DRAM_CAS: U2.L18 (DRAM_CAS), U4.K3 (~CAS)
/RAM/DRAM_CS0: U2.K18 (DRAM_CS0), U4.L2 (~CS)
/RAM/DRAM_D0: U2.H20 (DRAM_D0), U4.E3 (DQ0)
/RAM/DRAM_D1: U2.G21 (DRAM_D1), U4.F7 (DQ1)
/RAM/DRAM_D2: U2.J21 (DRAM_D2), U4.F2 (DQ2)
/RAM/DRAM_D3: U2.G20 (DRAM_D3), U4.F8 (DQ3)
/RAM/DRAM_D4: U2.J23 (DRAM_D4), U4.H3 (DQ4)
/RAM/DRAM_D5: U2.G23 (DRAM_D5), U4.H8 (DQ5)
/RAM/DRAM_D6: U2.J22 (DRAM_D6), U4.G2 (DQ6)
/RAM/DRAM_D7: U2.G22 (DRAM_D7), U4.H7 (DQ7)
/RAM/DRAM_D8: U2.E21 (DRAM_D8), U4.D7 (DQ8)
/RAM/DRAM_D9: U2.D21 (DRAM_D9), U4.C3 (DQ9)
/RAM/DRAM_D10: U2.E22 (DRAM_D10), U4.C8 (DQ10)
/RAM/DRAM_D11: U2.D20 (DRAM_D11), U4.C2 (DQ11)
/RAM/DRAM_D12: U2.E23 (DRAM_D12), U4.A7 (DQ12)
/RAM/DRAM_D13: U2.C23 (DRAM_D13), U4.A2 (DQ13)
/RAM/DRAM_D14: U2.F23 (DRAM_D14), U4.B8 (DQ14)
/RAM/DRAM_D15: U2.C22 (DRAM_D15), U4.A3 (DQ15)
/RAM/DRAM_DQM0: U2.H21 (DRAM_DQM0), U4.E7 (LDM)
/RAM/DRAM_DQM1: U2.E20 (DRAM_DQM1), U4.D3 (UDM)
/RAM/DRAM_RAS: U2.J19 (DRAM_RAS), U4.J3 (~RAS)
/RAM/DRAM_RESET: U2.P18 (DRAM_RESET), U4.T2 (~RESET)
/RAM/DRAM_SDBA0: U2.R19 (DRAM_SDBA0), U4.M2 (BA0)
/RAM/DRAM_SDBA1: U2.P20 (DRAM_SDBA1), U4.N8 (BA1)
/RAM/DRAM_SDBA2: U2.N19 (DRAM_SDBA2), U4.M3 (BA2)
/RAM/DRAM_SDCKE0: U2.H19 (DRAM_SDCKE0), U4.K9 (CKE)
/RAM/DRAM_SDCLK_0: R30.1, U2.K23 (DRAM_SDCLK_0), U4.J7 (CK)
/RAM/DRAM_SDCLK_0_B: R30.2, U2.K22 (~DRAM_SDCLK_0_B), U4.K7 (~CK)
/RAM/DRAM_SDODT0: U2.J18 (DRAM_SDODT0), U4.K1 (ODT)
/RAM/DRAM_SDQS0: U2.H23 (DRAM_SDQS0), U4.F3 (LDQS)
/RAM/DRAM_SDQS0_B: U2.H22 (~DRAM_SDQS0_B), U4.G3 (~LDQS)
/RAM/DRAM_SDQS1: U2.D23 (DRAM_SDQS1), U4.C7 (UDQS)
/RAM/DRAM_SDQS1_B: U2.D22 (~DRAM_SDQS1_B), U4.B7 (~UDQS)
/RAM/DRAM_WE: U2.L19 (DRAM_SDWE), U4.L3 (~WE)
GND: C89.2, C91.2, C93.2, C94.2, C95.2, C96.2, C97.2, C98.2, C99.2, C100.2, C101.2, C102.2, C103.2, C104.2, C105.2, C106.2, R24.1, R27.1, R29.1, U4.A9 (VSS1), U4.B1 (VSSQ1), U4.B3 (VSS2), U4.B9 (VSSQ2), U4.D1 (VSSQ3), U4.D8 (VSSQ4), U4.E1 (VSS3), U4.E2 (VSSQ5), U4.E8 (VSSQ6), U4.F9 (VSSQ7), U4.G1 (VSSQ8), U4.G8 (VSS4), U4.G9 (VSSQ9), U4.J2 (VSS5), U4.J8 (VSS6), U4.M9 (VSS8), U4.P1 (VSS9), U4.P9 (VSS10), U4.T1 (VSS11), U4.T9 (VSS12); also elsewhere on the board
PMIC_DDR_1V5: C90.1, C94.1, C95.1, C96.1, C97.1, C98.1, C99.1, C100.1, C101.1, C102.1, C103.1, C104.1, C105.1, C106.1, R15.2, U4.A1 (VDDQ1), U4.A8 (VDDQ2), U4.B2 (VDD1), U4.C1 (VDDQ3), U4.C9 (VDDQ4), U4.D2 (VDDQ5), U4.D9 (VDD2), U4.E9 (VDDQ6), U4.F1 (VDDQ7), U4.G7 (VDD3), U4.H2 (VDDQ8), U4.H9 (VDDQ9), U4.K2 (VDD4), U4.K8 (VDD5), U4.N1 (VDD6), U4.N9 (VDD7), U4.R1 (VDD8), U4.R9 (VDD9); also elsewhere on the board

Notes on the sheet:
Place near the VDD balls.
Place near the VDDQ balls.

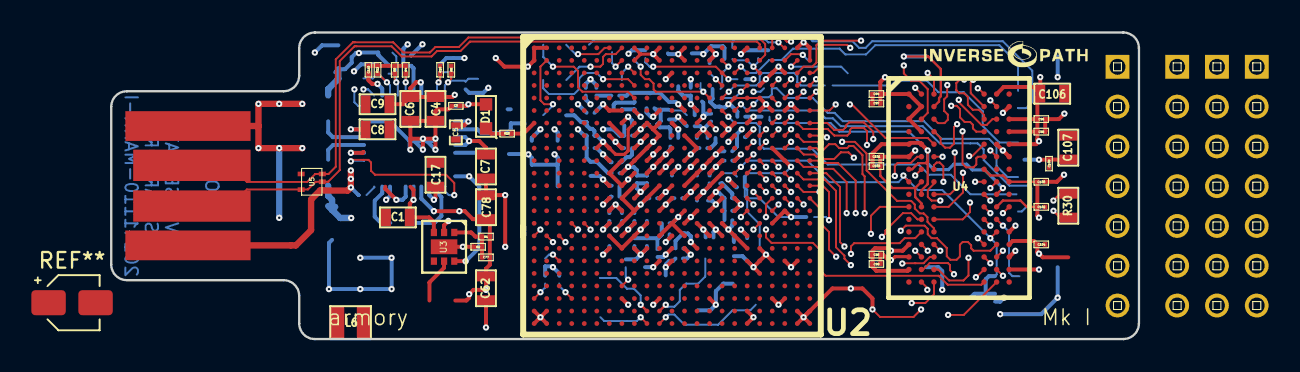
[picture p12: board armory.kicad_pcb from above]

Board: 8 copper layers, 65.6 x 19.6 mm, 183 parts (0 on the bottom side), 119 nets.

Other parts of the board:
P4#2, P4#3, P4#4: CONN_01X07; pinhead-1X7
Ref**: Val**; LOGO_SMALL

Their connections:
/Interfaces/GPIO5_26: P4#4.3; also elsewhere on the board
/Interfaces/GPIO5_27: P4#4.4; also elsewhere on the board
/Interfaces/GPIO5_30: P4#4.7; also elsewhere on the board
/Interfaces/UART1_RX: P4#4.6; also elsewhere on the board
/Interfaces/UART1_TX: P4#4.5; also elsewhere on the board
/Interfaces/USB_VBUS: P4#4.2; also elsewhere on the board
GND: P4#4.1; also elsewhere on the board
