ahmad-ih/USB-Armory/mark-two-debug-accessory/accessory.kicad_pcb

## KiCad design mark-two-debug-accessory/accessory.kicad_pcb (2020-02-04)

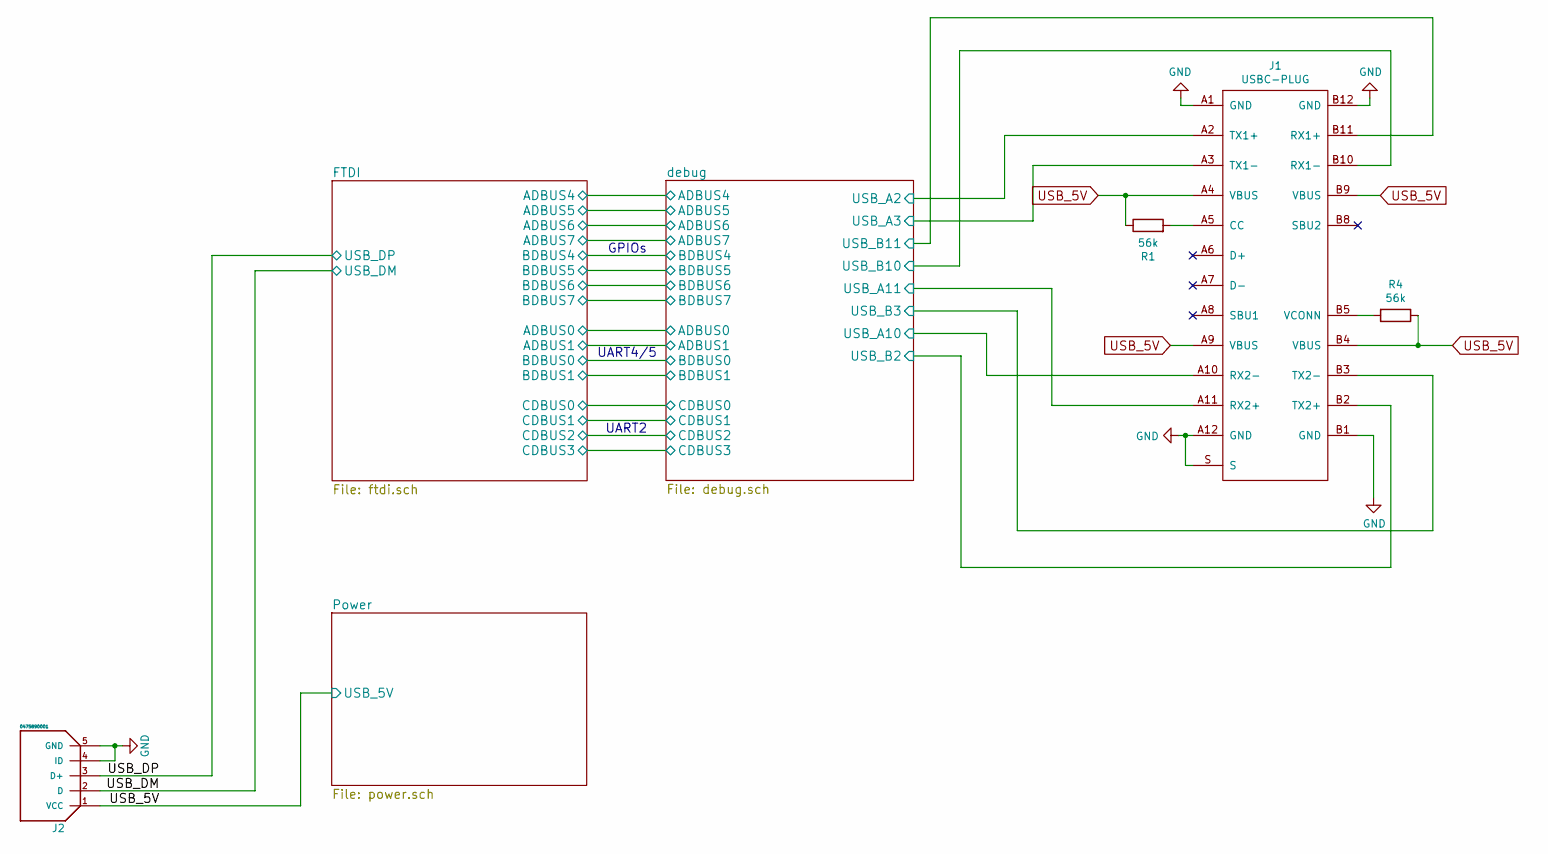
[picture p13: schematic accessory.sch, USB armory Mk II debug accessory]

Parts:
J1: USBC-PLUG; WURTH_632712000011; Mfg PN 632712000011
J2: 0475890001; MOLEX_0475890001; Mfg PN 0475890001
R1, R4: 56k; SM0603; Mfg PN MCT06030C5602FP500

Connections:
/USB_DM: J2.2 (D); also elsewhere on the board
/USB_DP: J2.3 (D+); also elsewhere on the board
/debug/USB_A2: J1.A2 (TX1+); also elsewhere on the board
/debug/USB_A3: J1.A3 (TX1-); also elsewhere on the board
/debug/USB_A10: J1.A10 (RX2-); also elsewhere on the board
/debug/USB_A11: J1.A11 (RX2+); also elsewhere on the board
/debug/USB_B2: J1.B2 (TX2+); also elsewhere on the board
/debug/USB_B3: J1.B3 (TX2-); also elsewhere on the board
/debug/USB_B10: J1.B10 (RX1-); also elsewhere on the board
/debug/USB_B11: J1.B11 (RX1+); also elsewhere on the board
GND: J1.A1 (GND), J1.A12 (GND), J1.B1 (GND), J1.B12 (GND), J1.S, J2.4 (ID), J2.5 (GND); also elsewhere on the board
unnamed: J1.A5 (CC), R1.2
unnamed: J1.B5 (VCONN), R4.2
USB_5V: J1.A4 (VBUS), J1.A9 (VBUS), J1.B4 (VBUS), J1.B9 (VBUS), J2.1 (VCC), R1.1, R4.1; also elsewhere on the board

Notes on the sheet:
GPIOs
UART4/5
UART2

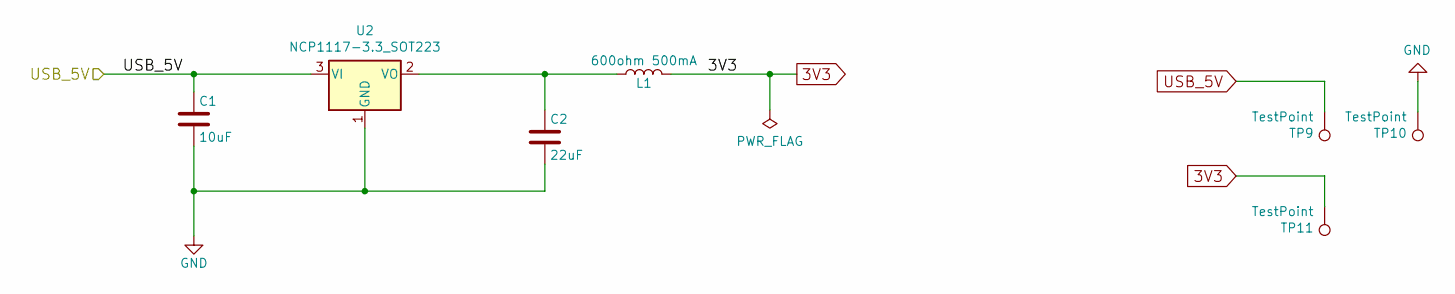
[picture p14: schematic power.sch, USB armory Mk II debug accessory]

Parts:
C1: 10uF; SM0603; Mfg PN C1608X5R1A106M080AC
C2: 22uF; SM0603; Mfg PN C1608X5R1A226M080AC
L1: 600ohm 500mA; SM0603; Mfg PN BLM18AG601SN1D
TP9, TP10, TP11: TestPoint; CONN_1
U2: NCP1117-3.3_SOT223; SOT-223; Mfg PN NCP1117ST33T3G

Connections:
3V3: L1.2, TP11.1; also elsewhere on the board
GND: C1.2, C2.2, TP10.1, U2.1 (GND); also elsewhere on the board
unnamed: C2.1, L1.1, U2.2 (VO)
USB_5V: C1.1, TP9.1, U2.3 (VI); also elsewhere on the board

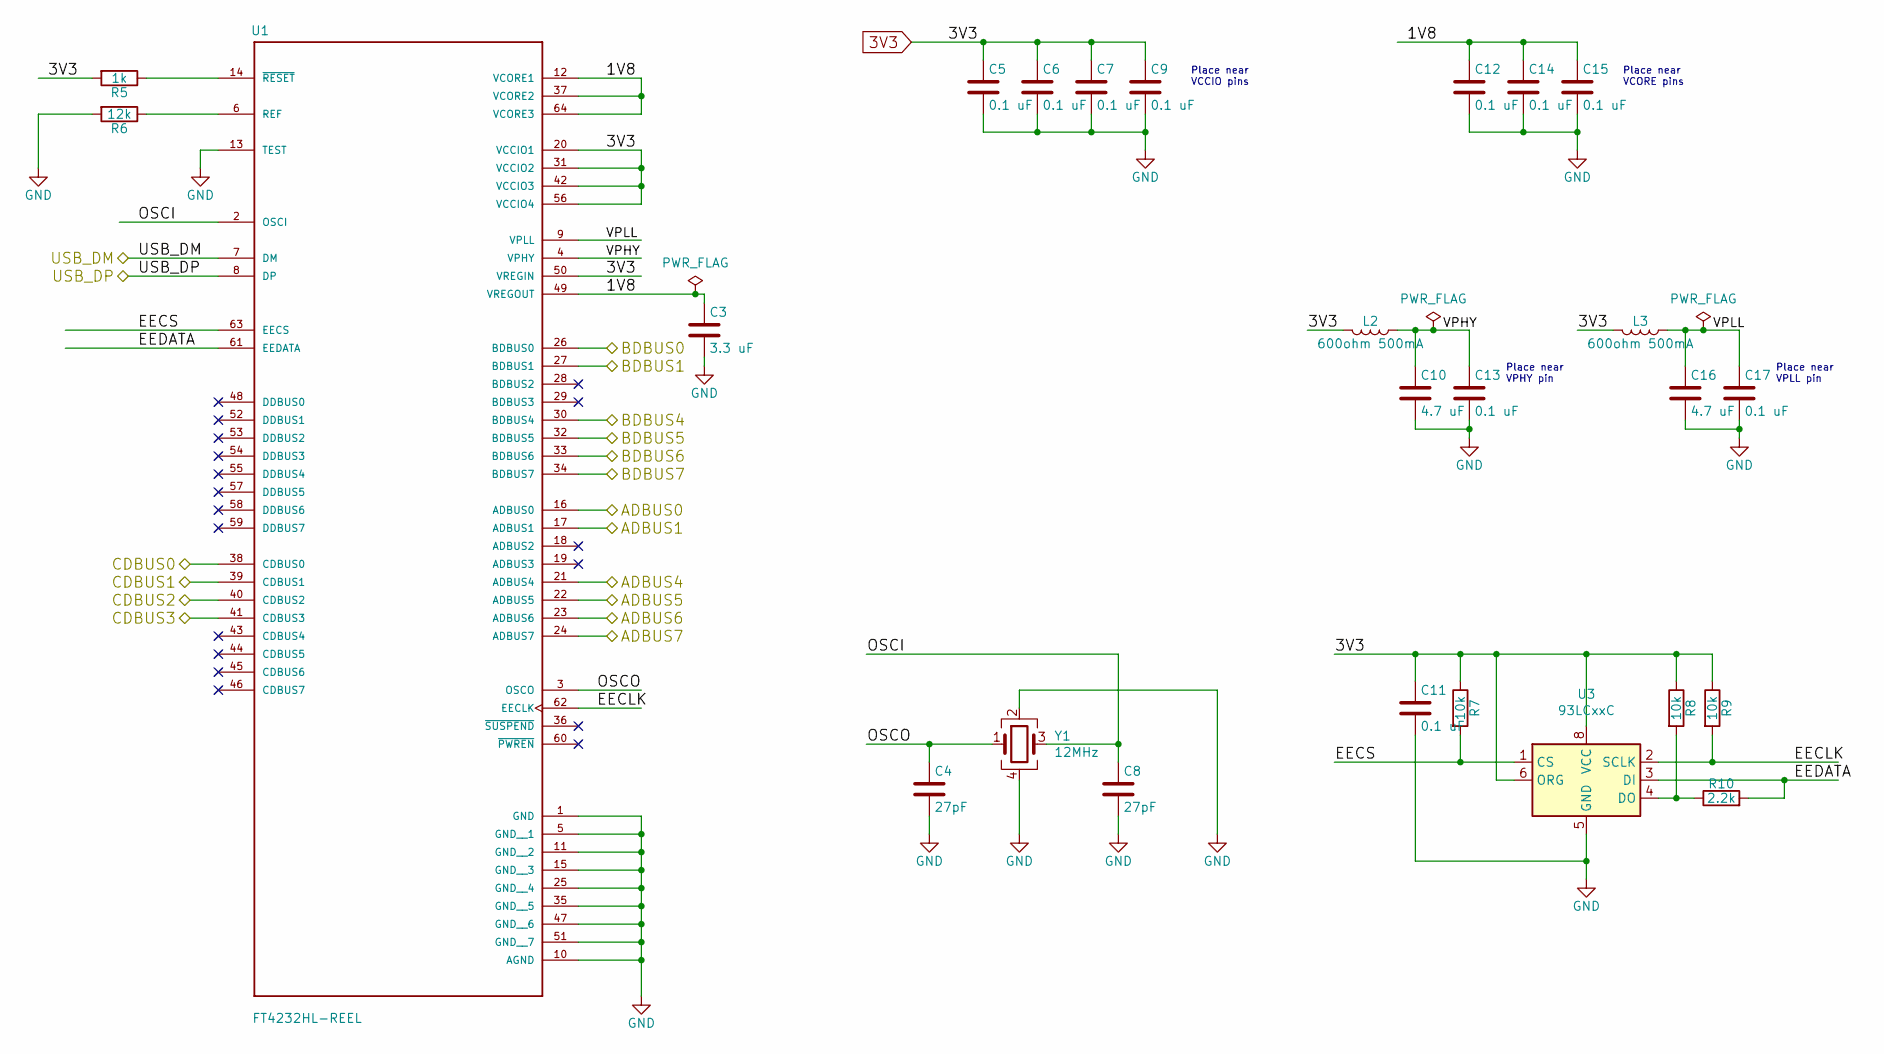
[picture p15: schematic ftdi.sch, USB armory Mk II debug accessory]

Parts:
C3: 3.3 uF; SM0603; Mfg PN C1608X5R1C335K080AC
C4, C8: 27pF; SM0603; Mfg PN GRM1885C1H270FA01D
C5, C6, C7, C9, C11, C12, C13, C14, C15, C17: 0.1 uF; SM0603; Mfg PN C1608X7R1E104K080AA
C10, C16: 4.7 uF; SM0603; Mfg PN CGB3B1X5R1A475M055AC
L2, L3: 600ohm 500mA; SM0603; Mfg PN BLM18AG601SN1D
R5: 1k; SM0603; Mfg PN RCA06031K00FKEAHP
R6: 12k; SM0603; Mfg PN CRCW060312K0FKEAC
R7, R8, R9: 10k; SM0603; Mfg PN CRCW060310K0FKEA
R10: 2.2k; SM0603; Mfg PN RCS06032K20JNEA
U1: FT4232HL-REEL; QFP50P1200X1200X160-64N; Mfg PN FT4232HL-REEL
U3: 93LCxxC; 8L_SOIC_Narrow_3_90_SN_C04-057C; Mfg PN 93LC56C-I/SN
Y1: 12MHz; TXC-3.2x2.5; Mfg PN 7M-12.000MAAJ-T

Connections:
3V3: C5.1, C6.1, C7.1, C9.1, C11.1, L2.1, L3.1, R5.2, R7.1, R8.1, R9.1, U1.20 (VCCIO1), U1.31 (VCCIO2), U1.42 (VCCIO3), U1.50 (VREGIN), U1.56 (VCCIO4), U3.6 (ORG), U3.8 (VCC); also elsewhere on the board
/FTDI/1V8: C3.1, C12.1, C14.1, C15.1, U1.12 (VCORE1), U1.37 (VCORE2), U1.49 (VREGOUT), U1.64 (VCORE3)
/FTDI/ADBUS0: U1.16 (ADBUS0); also elsewhere on the board
/FTDI/ADBUS1: U1.17 (ADBUS1); also elsewhere on the board
/FTDI/ADBUS4: U1.21 (ADBUS4); also elsewhere on the board
/FTDI/ADBUS5: U1.22 (ADBUS5); also elsewhere on the board
/FTDI/ADBUS6: U1.23 (ADBUS6); also elsewhere on the board
/FTDI/ADBUS7: U1.24 (ADBUS7); also elsewhere on the board
/FTDI/BDBUS0: U1.26 (BDBUS0); also elsewhere on the board
/FTDI/BDBUS1: U1.27 (BDBUS1); also elsewhere on the board
/FTDI/BDBUS4: U1.30 (BDBUS4); also elsewhere on the board
/FTDI/BDBUS5: U1.32 (BDBUS5); also elsewhere on the board
/FTDI/BDBUS6: U1.33 (BDBUS6); also elsewhere on the board
/FTDI/BDBUS7: U1.34 (BDBUS7); also elsewhere on the board
/FTDI/CDBUS0: U1.38 (CDBUS0); also elsewhere on the board
/FTDI/CDBUS1: U1.39 (CDBUS1); also elsewhere on the board
/FTDI/CDBUS2: U1.40 (CDBUS2); also elsewhere on the board
/FTDI/CDBUS3: U1.41 (CDBUS3); also elsewhere on the board
/FTDI/EECLK: R9.2, U1.62 (EECLK), U3.2 (SCLK)
/FTDI/EECS: R7.2, U1.63 (EECS), U3.1 (CS)
/FTDI/EEDATA: R10.2, U1.61 (EEDATA), U3.3 (DI)
/FTDI/OSCI: C8.1, U1.2 (OSCI), Y1.3
/FTDI/OSCO: C4.1, U1.3 (OSCO), Y1.1
/FTDI/VPHY: C10.1, C13.1, L2.2, U1.4 (VPHY)
/FTDI/VPLL: C16.1, C17.1, L3.2, U1.9 (VPLL)
/USB_DM: U1.7 (DM); also elsewhere on the board
/USB_DP: U1.8 (DP); also elsewhere on the board
GND: C3.2, C4.2, C5.2, C6.2, C7.2, C8.2, C9.2, C10.2, C11.2, C12.2, C13.2, C14.2, C15.2, C16.2, C17.2, R6.2, U1.1 (GND), U1.5 (GND__1), U1.10 (AGND), U1.11 (GND__2), U1.13 (TEST), U1.15 (GND__3), U1.25 (GND__4), U1.35 (GND__5), U1.47 (GND__6), U1.51 (GND__7), U3.5 (GND), Y1.2, Y1.4; also elsewhere on the board
unnamed: R5.1, U1.14 (~RESET~)
unnamed: R6.1, U1.6 (REF)
unnamed: R8.2, R10.1, U3.4 (DO)

Notes on the sheet:
Place near VCORE pins
Place near VCCIO pins
Place near VPLL pin
Place near VPHY pin
