ahmad-ih/USB-Armory/mark-two-debug-accessory/accessory.kicad_pcb

## KiCad design mark-two-debug-accessory/accessory.kicad_pcb (continued)

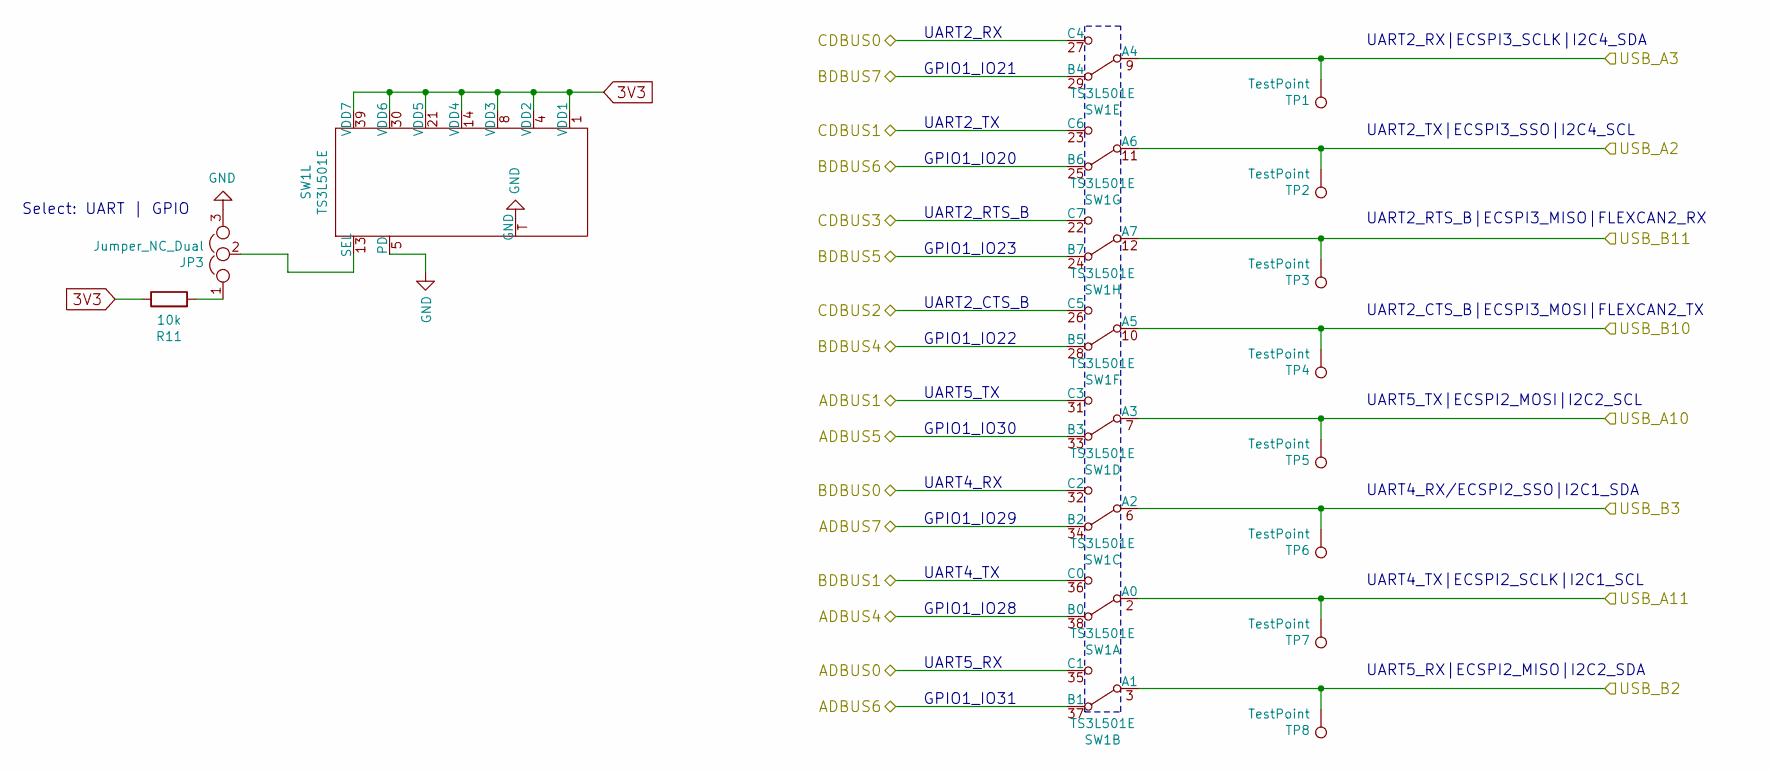
[picture p16: schematic debug.sch, USB armory Mk II debug accessory]

Parts:
JP3: Jumper_NC_Dual; SIL-3; Mfg PN 68000-103HLF
R11: 10k; SM0603; Mfg PN CRCW060310K0FKEA
SW1: TS3L501E; R-PWQFN-N42
TP1, TP2, TP3, TP4, TP5, TP6, TP7, TP8: TestPoint; CONN_1

Connections:
3V3: R11.1, SW1.1 (VDD1), SW1.4 (VDD2), SW1.8 (VDD3), SW1.14 (VDD4), SW1.21 (VDD5), SW1.30 (VDD6), SW1.39 (VDD7); also elsewhere on the board
/FTDI/ADBUS0: SW1.35 (C1); also elsewhere on the board
/FTDI/ADBUS1: SW1.31 (C3); also elsewhere on the board
/FTDI/ADBUS4: SW1.38 (B0); also elsewhere on the board
/FTDI/ADBUS5: SW1.33 (B3); also elsewhere on the board
/FTDI/ADBUS6: SW1.37 (B1); also elsewhere on the board
/FTDI/ADBUS7: SW1.34 (B2); also elsewhere on the board
/FTDI/BDBUS0: SW1.32 (C2); also elsewhere on the board
/FTDI/BDBUS1: SW1.36 (C0); also elsewhere on the board
/FTDI/BDBUS4: SW1.28 (B5); also elsewhere on the board
/FTDI/BDBUS5: SW1.24 (B7); also elsewhere on the board
/FTDI/BDBUS6: SW1.25 (B6); also elsewhere on the board
/FTDI/BDBUS7: SW1.29 (B4); also elsewhere on the board
/FTDI/CDBUS0: SW1.27 (C4); also elsewhere on the board
/FTDI/CDBUS1: SW1.23 (C6); also elsewhere on the board
/FTDI/CDBUS2: SW1.26 (C5); also elsewhere on the board
/FTDI/CDBUS3: SW1.22 (C7); also elsewhere on the board
/debug/USB_A2: SW1.11 (A6), TP2.1; also elsewhere on the board
/debug/USB_A3: SW1.9 (A4), TP1.1; also elsewhere on the board
/debug/USB_A10: SW1.7 (A3), TP5.1; also elsewhere on the board
/debug/USB_A11: SW1.2 (A0), TP7.1; also elsewhere on the board
/debug/USB_B2: SW1.3 (A1), TP8.1; also elsewhere on the board
/debug/USB_B3: SW1.6 (A2), TP6.1; also elsewhere on the board
/debug/USB_B10: SW1.10 (A5), TP4.1; also elsewhere on the board
/debug/USB_B11: SW1.12 (A7), TP3.1; also elsewhere on the board
GND: JP3.3, SW1.5 (PD), SW1.T (GND); also elsewhere on the board
unnamed: JP3.1, R11.2
unnamed: JP3.2, SW1.13 (SEL)

Notes on the sheet:
UART2_CTS_B|ECSPI3_MOSI|FLEXCAN2_TX
UART5_TX|ECSPI2_MOSI|I2C2_SCL
UART4_RX/ECSPI2_SSO|I2C1_SDA
UART4_TX|ECSPI2_SCLK|I2C1_SCL
UART5_RX|ECSPI2_MISO|I2C2_SDA
UART2_RTS_B|ECSPI3_MISO|FLEXCAN2_RX
UART2_TX|ECSPI3_SSO|I2C4_SCL
UART2_RX|ECSPI3_SCLK|I2C4_SDA
GPIO1_IO20
GPIO1_IO21
UART2_RX
UART2_TX
UART2_RTS_B
UART2_CTS_B
UART5_TX
UART4_RX
Select: UART | GPIO
UART4_TX
UART5_RX
GPIO1_IO23
GPIO1_IO22
GPIO1_IO30
GPIO1_IO29
GPIO1_IO28
GPIO1_IO31

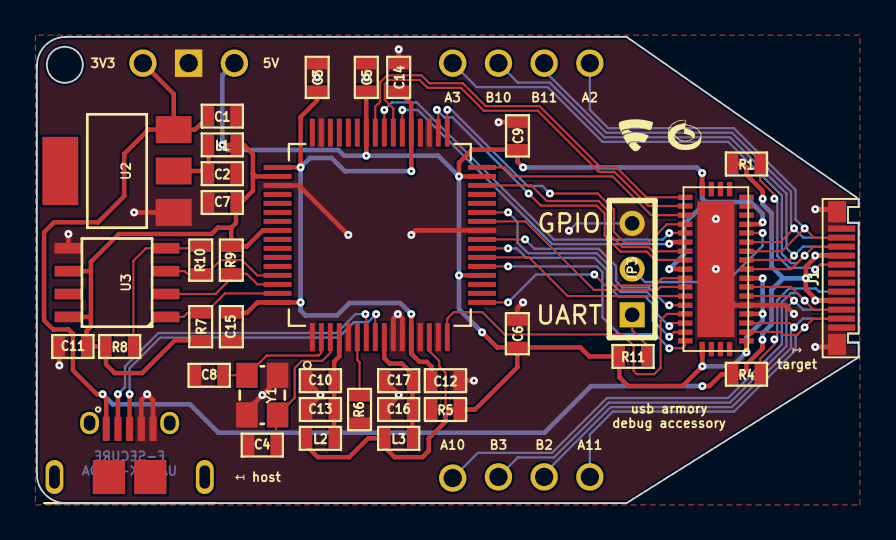
[picture p17: board accessory.kicad_pcb from above]

Board: 2 copper layers, 45.7 x 25.9 mm, 50 parts (0 on the bottom side), 45 nets.

Other parts of the board:
FSC_LOGO_NO_TEXT_SMALL: G***; FSC_LOGO_NO_TEXT_SMALL
Ref**: Val**; IP_LOGO_NO_TEXT_SMALL
