ahmad-ih/USB-Armory/(commit log)

2020-02-04 made changes
    [RAM-2020-02-04-19-07-55.sch, RAM.sch, USB-2020-02-04-19-07-55.sch, USB.sch, armory-2020-02-04-19-07-55.sch, armory.kicad_pcb, armory.sch, boot-2020-02-04-19-07-55.sch]
2020-04-04 removed zones
    [armory.kicad_pcb]
2020-04-04 added zones again
    [armory.kicad_pcb]
2020-04-04 modified zones
    [armory.kicad_pcb]
