ahmad-ih/USB-Armory/(notices)

Notices in the files:
mark-two/misc.sch:
Copyright © 2019 F-Secure
License: CERN OHL v1.2
mark-one/USB.sch:
Copyright © F-Secure Corporation
